eliasbitsch/PDE-Robotergreifer/videos/pde-projektplan/assets/work/ablauf_6_ablage.png

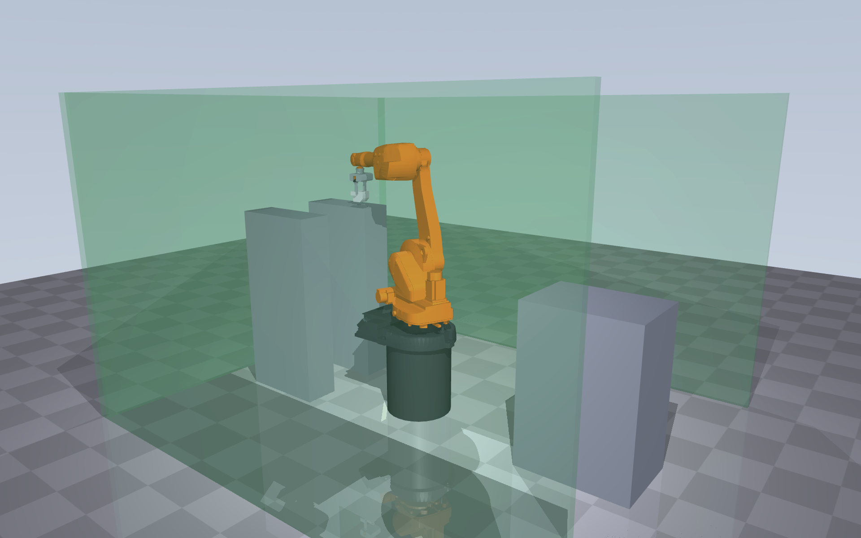
videos/pde-projektplan/assets/work/ablauf_6_ablage.png
