eliasbitsch/PDE-Robotergreifer/out/bilder/greifer_seite.png

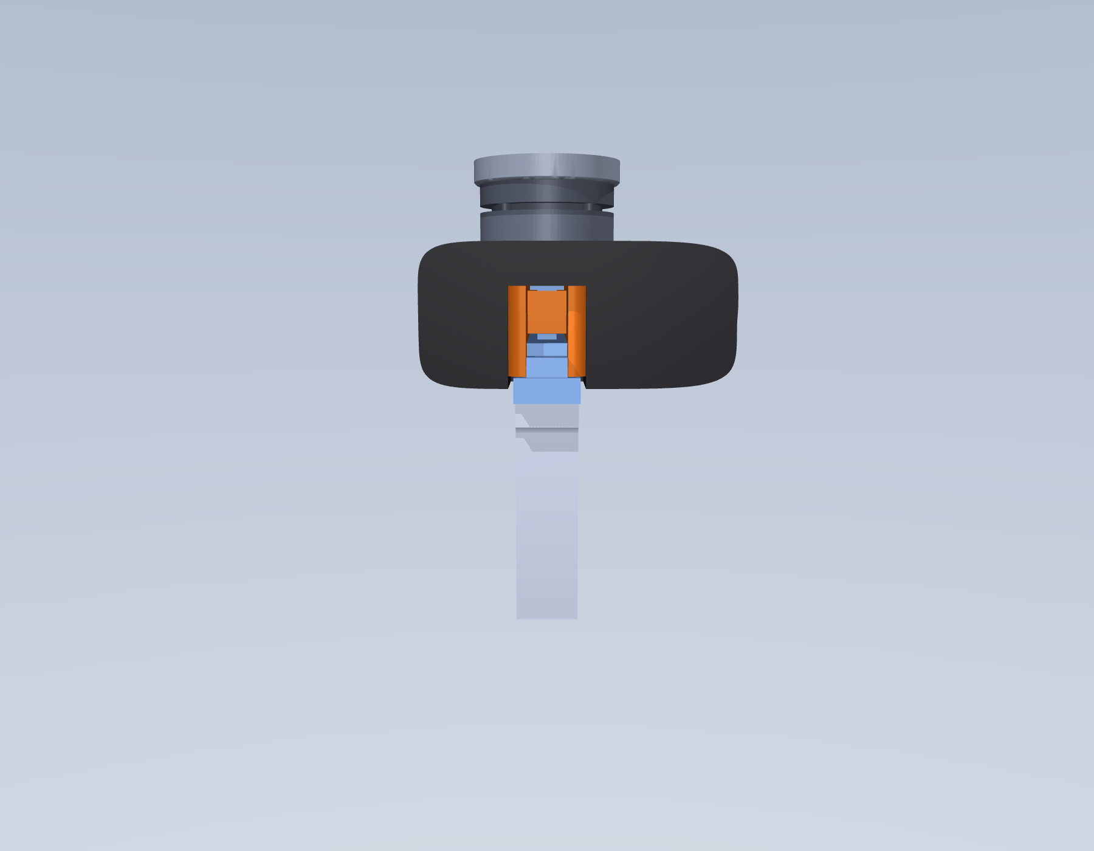
out/bilder/greifer_seite.png
