eliasbitsch/PDE-Robotergreifer/Elias/README.md

# Elias — System & Integration

Arbeitsbereich Bitsch Elias. Siehe [PLAN.md](../PLAN.md), Abschnitt 4.

| Ordner | Paket | Ergebnis |
|---|---|---|
| `01_Roboter` | E1 | Roboterauswahl, Aufstellungsstudie (Sockel 500 mm + Basisversatz 100 mm), Erreichbarkeitsnachweis |
| `02_CAD_Grundkoerper` | E2 | Gehaeuse, Antriebseinheit (Servo + Planetengetriebe + Haltebremse), Ritzel/Zahnstange, Fuehrung, Schnellwechsler, Roboterflansch |
| `03_Zeichnung` | E3 | Baugruppenzeichnung A3 + Stueckliste |
| `04_Simulation` | E4 | MuJoCo-Modell, Bahn Entnahme -> Ablage, Kollisionsprotokoll, Ablaufvideo |

Zusaetzlich E5: Infrastruktur (Repo, Onshape-Dokument, MCP-Anbindung, Parametertabelle) in `../gemeinsam/`.

**Schnittstelle zu Viktoriia:** die Anschraubebene Schlitten <-> Zange.
Ab KW 41 eingefroren, Aenderungen nur gemeinsam.
