eliasbitsch/PDE-Robotergreifer/gemeinsam/README.md

# Gemeinsam

| Ordner | Inhalt |
|---|---|
| `abgabe` | finale Abgabestruktur nach Abb. 2 der Angabe (4 Ordner), wird am Ende befuellt |
| `referenzen` | Datenblaetter, Normen, Literatur, Quellen fuer Reibwerte und Werkstoffkennwerte |

Hier liegen ausserdem die gemeinsame Parametertabelle und die Doku-Vorlage.

**Regel:** in `abgabe/` wird erst am Ende zusammengefuehrt, bewusst und gemeinsam.
Bis dahin arbeitet jede/r im eigenen Ordner.
