eliasbitsch/PDE-Robotergreifer/PLAN.md

# Projektplan — Robotergreifer, Bauteil B

**LV:** Produktdesign und Produktentwicklung, MRE WS 2026/27
**Gruppe:** 10 · **Bauteil:** B (PA 6, Ra 1,6)
**Team:** Bitsch Elias · Ovdiienko Viktoriia
**LV-Gruppen:** getrennt (BB-1 / BB-2) — Zwischenbericht und Endabgabe fahren wir **gemeinsam nach BB-1**
**Stand:** 14.09.2026 — Vorschlag, noch nicht abgestimmt

---

## 1. Worum es geht

Ein Roboter nimmt Bauteil B vom Pufferband (Höhe 1000 mm), fährt 1800 mm
horizontal und legt es auf einem Werkstückträger ab (Höhe 1300 mm).
Taktzeit 5 s je Bauteil. Wir konstruieren den Greifer dafür — das Bauteil
selbst ist gegeben und wird nicht verändert.

Abzugeben sind acht Punkte laut Angabe (Roboterauswahl, Greifkonzept,
Greifkraftberechnung, 3D-Konstruktion, analytische Festigkeit, FEM,
Baugruppenzeichnung, Ablaufsimulation mit Kollisionskontrolle), abgelegt in
der Ordnerstruktur aus Abb. 2 der Angabe.

---

## 2. Technische Festlegungen

Sechs Entscheidungen. Wenn Viktoriia eine davon anders sieht, ist **jetzt** der
richtige Zeitpunkt — nach dem Design Freeze in KW 40 kostet jede Änderung die
halbe Kette.

> **Geändert am 15.09.2026:** Die Mechanik war zuerst Zahnstange–Ritzel. Der
> Variantenvergleich in `cad/mechanismus.py` hatte mit Zahnstange, Keilhaken und
> Trapezspindel nur direkt übersetzende Schubmechanismen im Feld — die Familie
> der Gelenkgetriebe fehlte. Mit dem Viergelenk dazu kippt das Ergebnis, vor
> allem beim Kriterium „Halten bei Energieausfall": die selbsthemmende Spindel
> erspart die Haltebremse, die die Zahnstange zwingend gebraucht hätte.

| Thema | Festlegung | Warum |
|---|---|---|
| **Greifkonzept** | 2-Finger-Parallelgreifer, Backen | Bauteil B hat zwei ebene, parallele Seitenflächen im Abstand 70 mm. Formschluss ist nicht nötig, Reibschluss reicht. |
| **Antrieb** | **Servomotor** mit selbsthemmender Spindel bzw. Schnecke | Regelbare Greifkraft (PA 6 ist weich, Ra 1,6 darf nicht leiden), leise, keine Druckluft. **Selbsthemmend → keine Haltebremse nötig.** Das war bei der Zahnstange noch zwingend. |
| **Mechanik** | **Viergelenk (Parallelogramm) je Finger**, ein Motor treibt beide | Bauform nach Vorbild Robotiq 2F-85. Backen bleiben parallel, Spitze läuft auf einer Kreisbahn. Ohne die unteraktuierte Adaptivität des Originals — die ist im umgreifenden Modus statisch unbestimmt und bringt für zwei ebene Flächen nichts. |
| **CAD + FEM** | **Onshape** (parametrisch, browserbasiert) | Beide sehen dasselbe Modell live, keine Versionskonflikte, keine lokale Installation. FEM direkt am selben Modell, ohne Exportbruch. |
| **Berechnung / Doku** | **LaTeX** | Formeln, Einheiten und Querverweise bleiben konsistent; die Doku ist 10 Punkte wert und wächst ab M1 mit. |
| **Simulation** | **MuJoCo** | Siehe Abschnitt 3. |

### Kennwerte aus der Vorauslegung (zu bestätigen, nicht gesetzt)

- Bauteil B: 95 × 100 × 80 mm, 528,5 cm³, PA 6 (ρ = 1140 kg/m³) → **0,602 kg**
- Greifflächen: ±X, Backenabstand **70 mm**, 6200 mm² je Seite
- Bahnbeschleunigung aus Taktzeitbudget: **2,05 m/s²**
- Erforderliche Greifkraft: **14,3 N je Backe** (µ = 0,5 NBR/PA 6, S = 2,0)
- Startgeometrie Viergelenk (in V2 zu bestätigen): Lenkerlänge **90 mm**,
  Schwenkwinkel **±4,46°** um die Senkrechte zur Greifrichtung, Hub **14 mm je
  Seite** → **0,27 mm** Belagversatz über den Hub. Längere Lenker senken den
  Versatz weiter (120 mm → 0,20 mm), kürzere erhöhen ihn (40 mm → 0,62 mm).
- Referenz Robotiq 2F-85: elektrisch 24 V, **20–235 N**, 85 mm Hub, 5 kg
  Traglast, ~1,3 kg, Flansch ISO 9409-1-50-4-M6. Kraft ist in keiner Variante
  der Engpass — wir brauchen 14,3 N.
- Roboter: **ABB IRB 1600-6/1.45**
- Wichtigster Befund: Mit dem Roboter mittig auf dem Boden ist der Ablauf
  **nicht ausführbar** — nicht wegen der Reichweite, sondern wegen Achse 5
  (±115°). Lösung: **Sockel 500 mm + Basisversatz 100 mm**. Das gehört als
  Erkenntnis in den Bericht, nicht versteckt.

---

## 3. Simulation: MuJoCo statt Gazebo

**Entscheidung: MuJoCo.**

Gazebo wäre die richtige Wahl, wenn wir gegen einen echten ABB-Controller mit
ROS 2 und MoveIt fahren würden — Sensorsimulation, Plugins, ganze Anlagenwelt.
Das brauchen wir nicht. Die Angabe verlangt "visuelle Darstellung inkl.
Kollisionskontrolle des Arbeitsablaufes", also Kinematik, Kollision und ein
Video.

Dafür ist MuJoCo besser:

- **Läuft ohne ROS**, direkt aus Python — kein Stack, der eine Woche Setup frisst
- **Kontaktkräfte** sind auswertbar. Wir können zeigen, dass das Bauteil unter
  der berechneten Greifkraft *tatsächlich* nicht rutscht, statt es nur zu
  behaupten. Das ist ein echtes Argument im Bericht.
- **Headless-Rendering** in guter Qualität → Bilder für die Doku und das Video
  entstehen im selben Lauf
- **Läuft bereits.** `sim/aufstellung.py` und `sim/ablauf.py` funktionieren,
  inklusive Levenberg-Marquardt-IK mit Konfigurationstreue. Das Rad ist schon
  rund.

Gazebo hätte gegenüber MuJoCo hier nur Nachteile: schwerer, ROS-abhängig, auf
Windows nur über WSL, und kein Mehrwert für das, was abgegeben wird.

---

## 3a. Wofür es Punkte gibt

100 Punkte insgesamt. Die Verteilung steht in der Einführungsfolie und sie ist
der wichtigste Planungsinput überhaupt:

| Arbeitspaket | Punkte | Wer |
|---|---:|---|
| **3D-Konstruktion des Greifers** | **20** | Elias + Viktoriia |
| Allgemein (Ausführung der technischen Dokumentation) | 10 | beide |
| Auswahl eines geeigneten Roboters inkl. Begründung | 10 | Elias |
| Konzeptskizze des Greifers | 10 | Viktoriia |
| Berechnung und mechanische Auslegung des Greifmechanismus | 10 | Viktoriia |
| Analytische Berechnung der Greiferzange | 10 | Viktoriia |
| Numerische Berechnung der Greiferzange (FEM) | 10 | Elias |
| Baugruppenzeichnung inklusive Stückliste | 10 | Elias |
| Kollisionskontrolle und visuelle Darstellung des Arbeitsablaufes | 10 | Elias |

**Notenskala:** ≥88 % Sehr Gut · ≥75 % Gut · ≥63 % Befriedigend · ≥50 % Genügend · <50 % Nicht genügend

Zwei Schlüsse daraus:

- **Die 3D-Konstruktion ist doppelt gewichtet.** Sie bekommt die meiste Zeit
  und wird von beiden getragen — nicht nebenbei erledigt.
- **Die Dokumentation allein bringt 10 Punkte**, unabhängig vom Inhalt. Das
  ist die billigste Note im ganzen Projekt und wird deshalb nicht ans Ende
  geschoben (siehe unten).

### Die fünf Warnungen der LV-Leitung

Aus der Einführungsfolie, wörtlich — der Plan ist genau darauf gebaut:

| Warnung | Wie der Plan sie abfängt |
|---|---|
| 1. Konstruktion nicht ohne Berechnung beginnen | Greifkraft (V2) liegt in M1, **vor** dem CAD-Start in M2. Design Freeze trennt beides sauber. |
| 2. FEM nicht zu spät starten | Die FEM (E5) liegt in M3 und ist **vor** dem Zwischenbericht fertig, nicht danach. |
| 3. Zeichnungen: Aufwand nicht unterschätzen | Zeichnung + Stückliste (E3) startet im Dezember, nicht im Januar. Zwei volle Wochen. |
| 4. Dokumentation nicht erst in der letzten Woche | Läuft ab M1 mit. Jedes Paket wird geschrieben, **wenn** es fertig ist. Januar ist nur noch Zusammenführen. |
| 5. Zwischenbericht ernst nehmen | Eigener Meilenstein mit Inhaltsliste, 4 Tage Puffer davor. |

---

## 4. Aufgabenteilung

Zwei Hälften, die jede für sich eine geschlossene Geschichte erzählen.
Niemand bekommt Restarbeiten.

### Elias — System & Integration

| # | Paket | Ergebnis | Ordner |
|---|---|---|---|
| E1 | **Roboterauswahl & Aufstellung** | Auswahlrechnung (Reichweite, Taktzeit, Traglast), Aufstellungsstudie Sockel/Basisversatz, Nachweis der Erreichbarkeit aller Stützpunkte | `Elias/01_Roboter` |
| E2 | **Greifer-Grundkörper** | Gehäuse, Antriebseinheit (Servo + selbsthemmende Spindel), Viergelenk mit Lagerstellen, Schnellwechsler, Roboterflansch ISO 9409-1-50-4-M6 | `Elias/02_CAD_Grundkoerper` |
| E3 | **Baugruppenzeichnung & Stückliste** | A3-Zeichnung, Positionsnummern, Stückliste mit Kauf-/Fertigungsteilen | `Elias/03_Zeichnung` |
| E4 | **Ablaufsimulation & Kollisionskontrolle** | MuJoCo-Modell, Bahn Entnahme → Ablage, Kollisionsprotokoll, Ablaufvideo | `Elias/04_Simulation` |
| E5 | **FEM der Greiferzange** | Netz, Randbedingungen, Netzkonvergenz, Spannung und Verformung; Abgleich gegen Viktoriias analytische Rechnung | `Elias/05_FEM` |
| E6 | **Infrastruktur** | Repo, Onshape-Dokument, MCP-Anbindung, Parametertabelle, Doku-Vorlage | `gemeinsam/` |

### Viktoriia — Auslegung & Nachweis

| # | Paket | Ergebnis | Ordner |
|---|---|---|---|
| V1 | **Greifkonzept & Konzeptskizze** | Variantenvergleich nach VDI 2225 — **mit dem Robotiq 2F-85 als marktüblicher Referenz im Feld**, dazu Viergelenk, Zahnstange, Keilhaken, Spindel. Begründung der Wahl, bemaßte Konzeptskizze | `Viktoriia/01_Konzept` |
| V2 | **Greifkraft & Antriebsauslegung** | Kraftbilanz (Gewicht + Beschleunigung + Sicherheit), Reibwert mit Quelle, Flächenpressung auf PA 6, **Viergelenk über virtuelle Arbeit mit Nachweis des Übertragungswinkels im ungünstigsten Punkt**, Spindelauslegung inkl. Selbsthemmung, Motorauswahl mit Reserve | `Viktoriia/02_Auslegung` |
| V3 | **Greiferzange & Weichbacken (CAD)** | Parametrische Zange in Onshape, Backentasche, Kontur passend zu Bauteil B | `Viktoriia/03_CAD_Zange` |
| V4 | **Analytischer Festigkeitsnachweis** | Biegespannung und Durchbiegung der Zange von Hand gerechnet, Annahmen und Quellen sauber belegt — die Referenz, gegen die die FEM antritt | `Viktoriia/04_Nachweis` |
| V5 | **FDM-Validierung** | Zange drucken, Durchbiegung unter definierter Last messen, gegen Elias' FEM halten | `Viktoriia/05_FDM` |

**Warum dieser Schnitt:** Viktoriia konstruiert die Zange und rechnet sie
analytisch durch. Elias rechnet dieselbe Zange numerisch nach. Damit prüfen
zwei Personen unabhängig dasselbe Bauteil auf zwei Wegen — genau das verlangt
die Angabe, und eine Abweichung fällt sofort auf, statt sich in einer Hand zu
verstecken.

Der gedruckte Nachweis (V5) liegt aus demselben Grund bei Viktoriia: wer die
FEM gerechnet hat, soll sie nicht selbst bestätigen. Die Schnittstelle zwischen beiden ist eine
einzige Fläche: die **Anschraubebene Schlitten ↔ Zange**. Die wird in KW 41
festgelegt und danach nicht mehr angefasst.

### Gemeinsam

- **Dokumentation** — jede/r schreibt die eigenen Kapitel, gegenseitiges Review
- **Cross-Review** vor jedem Meilenstein: Elias prüft Viktoriias Rechnungen
  nach, Viktoriia prüft Elias' Modell auf Fertigbarkeit
- **Abgabe-ZIP** in der Struktur aus Abb. 2

---

## 5. Die FDM-Idee

Das verlangt niemand — aber es ist billig und hebt die Arbeit deutlich.

Wir drucken die Greiferzange aus PLA/PETG im Maßstab 1:1, klemmen sie ein,
hängen eine definierte Last ans freie Ende und **messen die Durchbiegung**.
Dann rechnen wir dieselbe Geometrie mit dem E-Modul des Druckwerkstoffs neu
und vergleichen drei Zahlen: analytisch, FEM, gemessen.

Was das bringt:

- Der Vergleich analytisch/numerisch wird vom Pflichtpunkt zum belastbaren
  Ergebnis — mit einem realen dritten Datenpunkt
- Man sieht sofort, ob die Einspannung im FEM-Modell zu steif angenommen war.
  Das ist der klassische Fehler und wir können ihn belegen statt vermuten.
- Die gedruckte Zange lässt sich im Video zeigen. Eine echte Backe in der Hand
  schlägt jedes Rendering.

**Wichtig für die Ehrlichkeit im Bericht:** Gedruckt wird PLA, gebaut wird
EN AW-7075. Der Test validiert das *Modell* (Randbedingungen, Lasteinleitung,
Netz), nicht das Bauteil. Genau so schreiben wir es hin.

---

## 6. Timeline

### Die zwei harten Termine

Wir sind in getrennten LV-Gruppen, liefern aber gemeinsam ab. Wir fahren beide
nach **BB-1** — das sind die **früheren** Termine:

| | Termin | Was |
|---|---|---|
| 🔴 **Zwischenbericht** | **Do 26.11.2026, 17:50, Präsenz** | BB-1 statt BB-2 (03.12.) — eine Woche früher |
| 🔴 **Endkontrolle** | **Fr 15.01.2027, 16:10, Präsenz** | BB-1 statt BB-2 (22.01.) — eine Woche früher |

**Das kostet uns je eine Woche Puffer.** Bewusste Entscheidung, aber sie muss
mit der LV-Leitung (Saliger) abgesprochen sein — wer in BB-2 ist, präsentiert
beim Zwischenbericht in einer fremden Gruppe. Das ist Punkt 0 auf der
Klärliste.

### LV-Termine als Taktgeber (BB-1)

Die Vorlesungen geben den Rhythmus vor — wir legen die Pakete dahinter, nicht
davor:

| Datum | Thema | Was das für uns heißt |
|---|---|---|
| Do 17.09. | Einführung OnShape | CAD-Start **danach**, nicht davor |
| Sa 19.09. | Modellierung und Zeichnung | Modellier-Handwerkszeug sitzt |
| Di 22.09. | StüLi, Blech, MDB | Stücklisten-Logik für E3 |
| Sa 24.10. | Baugruppen, Datenaustausch | fällt genau in die CAD-Phase — Timing passt |
| Mi 04.11. | Digitale Absicherung, Simulation | direkt vor der Simulationsphase |
| **Do 26.11.** | **Zwischenbericht** | 🔴 |
| Mi 02.12. | CAE–CAD–CAP–CAM Prozesskette | — |
| **Fr 15.01.** | **Endkontrolle, Fragestunde** | 🔴 |

### Meilensteine

| Meilenstein | Deadline | Ergebnis | Wer |
|---|---|---|---|
| **M0 — Kickoff** | So 20.09. | Plan abgestimmt, Rollen fix, Onshape + Repo stehen, Klärliste raus | beide |
| **M1 — Konzept steht** | So 04.10. | Roboter gewählt (E1), Greifkonzept + Skizze (V1), Greifkraft gerechnet (V2) → **Design Freeze** | beide |
| **M2 — CAD schließt** | So 01.11. | Zange (V3) und Grundkörper (E2) getrennt konstruiert, Baugruppe schließt kollisionsfrei, Schnittstelle eingefroren | beide |
| **M3 — Nachweise** | So 22.11. | Analytisch fertig (V4), FEM gerechnet inkl. Netzkonvergenz (E5), beide Wege verglichen | beide |
| 🔴 **Zwischenbericht** | **Do 26.11.** | Präsentation: Konzept, Auslegung, CAD, erste Nachweise | beide |
| **M4 — Zeichnung + Simulation + FDM** | So 20.12. | Baugruppenzeichnung + Stückliste (E3), MuJoCo-Ablauf + Kollisionsprotokoll + Video (E4), Zange gedruckt und vermessen (V5) | parallel |
| *Weihnachtspause* | 21.12.–03.01. | — | — |
| **M5 — Zusammenführen** | So 11.01. | Doku zusammengeführt, Cross-Review, ZIP gepackt | beide |
| 🔴 **Endkontrolle** | **Fr 15.01.** | ZIP hochgeladen, Präsenztermin | beide |

**Puffer:** vor dem Zwischenbericht 4 Tage, vor der Endkontrolle 4 Tage. Das
ist knapp. Deshalb liegt die FEM-Kette **vor** dem Zwischenbericht und nicht
danach — wenn dort etwas schiefgeht, haben wir im Dezember noch Luft.

**Die Zeichnung liegt bewusst im Dezember, nicht im Januar.** Warnung 3 der
LV-Leitung. Zwei Wochen für Zeichnung und Stückliste sind nicht großzügig,
sondern realistisch.

**Dokumentation läuft ab M1 mit.** Jedes Paket wird geschrieben, wenn es
fertig ist, nicht am Ende. M5 ist Zusammenführen und Korrekturlesen — kein
Schreiben. Das ist Warnung 4, und sie ist 10 Punkte wert.

**Fixer Termin:** jede Woche ein kurzer Sync, 20 Minuten, Stand + Blocker.

---

## 7. Offene Punkte

Diese müssen früh geklärt werden, weil sie nach hinten teuer werden:

0. **Getrennte LV-Gruppen.** Wir sind in BB-1 und BB-2, wollen aber gemeinsam
   nach BB-1 fahren (Zwischenbericht 26.11., Endkontrolle 15.01.).
   Entspannend: laut Einführungsfolie muss **bei Zwischenbericht und
   Endkontrolle mindestens eine Person pro Gruppe anwesend sein** — nicht
   beide. Trotzdem mit Alexandra Saliger abklären, ob die Anwesenheit in der
   jeweils anderen Kohorte angerechnet wird. Zusätzlich gilt **75 %
   Anwesenheitspflicht**, die zählt jede/r in der eigenen Gruppe.
   **Vor allem anderen klären.**
1. **Gruppennummer.** `task.md` sagt Gruppe 10, Tab. 1 der Angabe kennt nur
   Gruppen 1–8 (Bauteil B = Gruppe 2). Bei der LV-Leitung nachfragen, bevor
   irgendein Dokument mit einer Nummer im Kopf gedruckt wird.
2. **Ablageorientierung am Werkstückträger.** Laut Angabe wird das bei der
   Angabenausgabe definiert. Aktuell mit 90° Drehung gerechnet. Wenn die
   Orientierung anders ist, ändert sich die Bahn und möglicherweise die
   Greifrichtung.
3. **FDM-Drucker.** Verfügbarkeit und Werkstoff klären (Labor oder privat).
3a. **Übertragungswinkel.** Beim Viergelenk ist die Backenkraft **nicht**
   konstant über den Hub. Der ungünstigste Punkt muss nachgewiesen werden —
   das ist der Preis für die Bauform und gehört in V2, nicht ans Ende.
3b. **Belagversatz auf der Greiffläche.** 0,27 mm Schrubben bei 90 mm Lenkern.
   Für Ra 1,6 auf PA 6 nachweisen, dass der Weichbelag das elastisch aufnimmt.
3c. **Onshape-FEM.** Prüfen, ob der Education-Plan die Simulation freischaltet.
   Falls nicht, springt die bestehende CalculiX-Kette ein — Ergebnis
   gleichwertig, nur mehr Handarbeit.
4. **Onshape-Lizenz.** Free-Plan macht Dokumente öffentlich. Für eine
   Studienarbeit ist das meist egal, sollte aber bewusst entschieden sein —
   Education-Plan ist kostenlos und privat.

---

## 8. Arbeitsweise im Repo

```
PDE/
├─ Elias/          ← Elias arbeitet nur hier
├─ Viktoriia/      ← Viktoriia arbeitet nur hier
├─ gemeinsam/      ← Parameter, Vorlagen, Abgabe-ZIP
│  ├─ abgabe/      ← finale Struktur nach Abb. 2
│  └─ referenzen/
├─ cad/ fem/ sim/  ← bestehende Skriptkette (Vorarbeit, bleibt als Referenz)
└─ PLAN.md
```

**Regel:** jede/r committet nur im eigenen Ordner. Dann gibt es keine
Merge-Konflikte. Zusammengeführt wird ausschließlich in `gemeinsam/abgabe/`,
und zwar am Ende, bewusst und gemeinsam.

Commit-Nachrichten auf Deutsch, eine Zeile, was sich geändert hat und warum.

---

## 9. Was Viktoriia dazu sagen soll

Der Plan ist ein **Vorschlag**, kein Beschluss. Konkret bitte Rückmeldung zu:

- Passt die Aufteilung? Wenn du lieber CAD statt FEM machst (oder umgekehrt),
  tauschen wir — die Pakete sind so geschnitten, dass V3↔E2 und V4↔E4 tauschbar
  sind.
- Onshape okay, oder arbeitest du lieber in etwas anderem? (SolidWorks,
  Fusion, Inventor — dann müssen wir nur die Schnittstelle über STEP klären.)
- Ist dir die Timeline zu eng oder zu locker?
- Die FEM ist bewusst zu Elias gewandert, damit deine Seite nicht überläuft.
  Du rechnest analytisch, er numerisch — zwei unabhängige Wege auf dasselbe
  Bauteil. Wenn du die FEM lieber selbst machst, tauschen wir zurück.
