eliasbitsch/PDE-Robotergreifer/Viktoriia/README.md

# Viktoriia — Auslegung & Nachweis

Arbeitsbereich Ovdiienko Viktoriia. Siehe [PLAN.md](../PLAN.md), Abschnitt 4.

| Ordner | Paket | Ergebnis |
|---|---|---|
| `01_Konzept` | V1 | Variantenvergleich Greifkonzept (VDI 2225), Begruendung, bemasste Konzeptskizze |
| `02_Auslegung` | V2 | Greifkraft (Gewicht + Beschleunigung + Sicherheit), Reibwert mit Quelle, Flaechenpressung auf PA 6, Ritzelmoment, Motorauswahl, Bremse |
| `03_CAD_Zange` | V3 | Greiferzange + Weichbacken, parametrisch in Onshape |
| `04_Nachweis` | V4 | Biegespannung und Durchbiegung analytisch, FEM mit Netzkonvergenz, Vergleich beider Wege |
| `05_FDM` | V5 | Zange gedruckt, Greifversuch, Durchbiegung gemessen, gegen FEM gehalten |

**Der rote Faden:** du konstruierst genau das Bauteil, das du danach berechnest,
pruefst und druckst. V3 -> V4 -> V5 ist eine Kette.

**Schnittstelle zu Elias:** die Anschraubebene Schlitten <-> Zange.
Ab KW 41 eingefroren, Aenderungen nur gemeinsam.

**Wenn dir etwas nicht passt:** Abschnitt 9 in PLAN.md. Die Pakete V3<->E2 und
V4<->E4 sind bewusst tauschbar geschnitten.
