eliasbitsch/PDE-Robotergreifer/angabe_bilder/s2_Image30.png

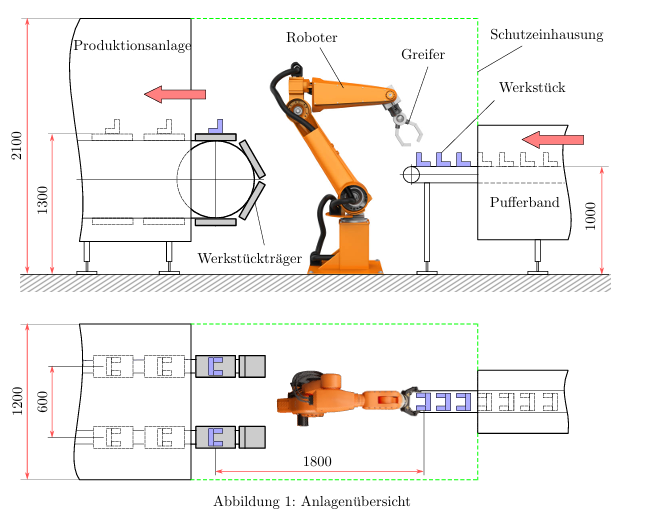
angabe_bilder/s2_Image30.png
