eliasbitsch/PDE-Robotergreifer/angabe_bilder/s3_Image33.jpg

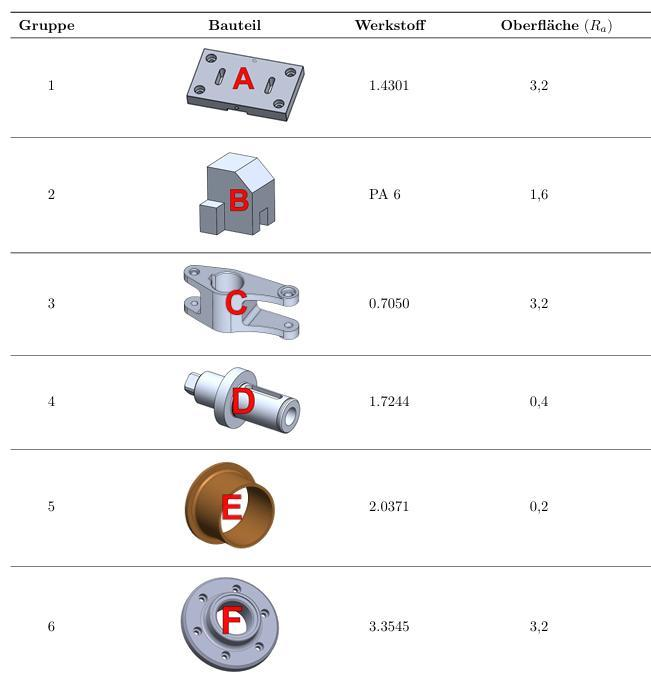
angabe_bilder/s3_Image33.jpg
