eliasbitsch/PDE-Robotergreifer/angabe_bilder/s3_Image34.jpg

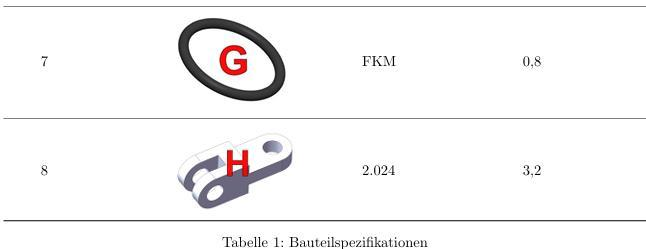
angabe_bilder/s3_Image34.jpg
