eliasbitsch/PDE-Robotergreifer/angabe_bilder/s5_Image47.png

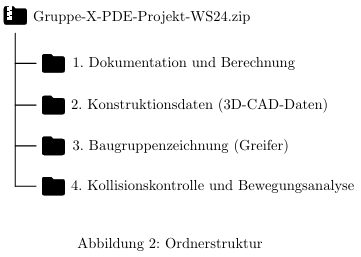
angabe_bilder/s5_Image47.png
