eliasbitsch/PDE-Robotergreifer/out/bilder/greifer_front.png

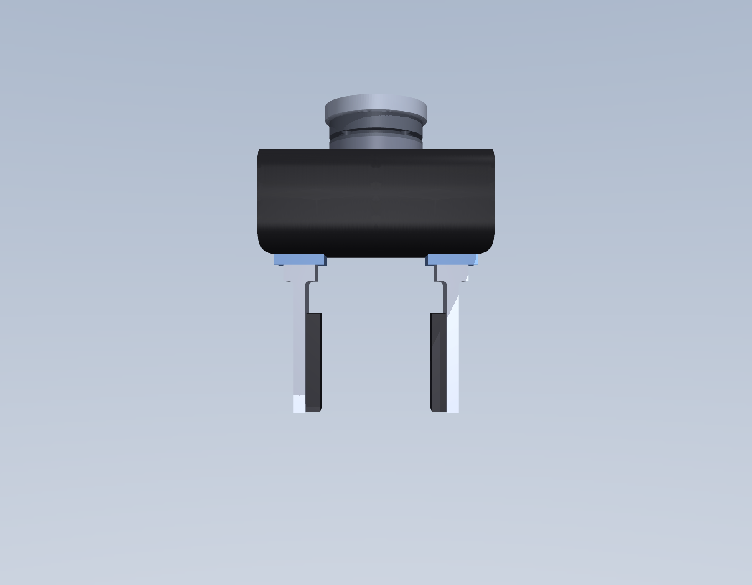
out/bilder/greifer_front.png
