eliasbitsch/PDE-Robotergreifer/out/bilder/greifer_mechanik.png

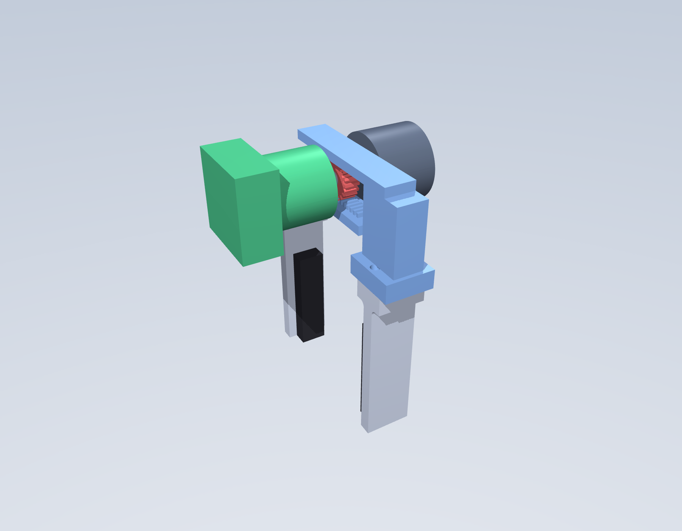
out/bilder/greifer_mechanik.png
