eliasbitsch/PDE-Robotergreifer/out/bilder/greifer_mechanik_oben.png

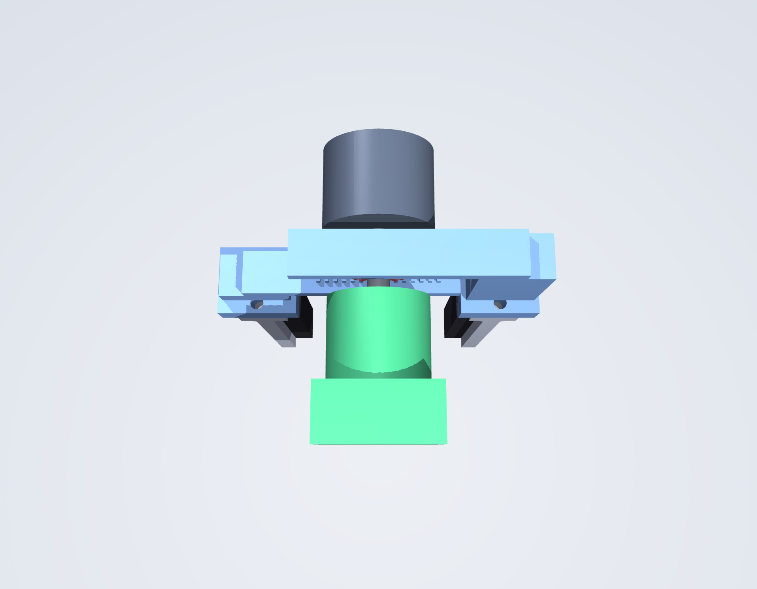
out/bilder/greifer_mechanik_oben.png
