eliasbitsch/PDE-Robotergreifer/out/bilder/onshape_design_zu.png

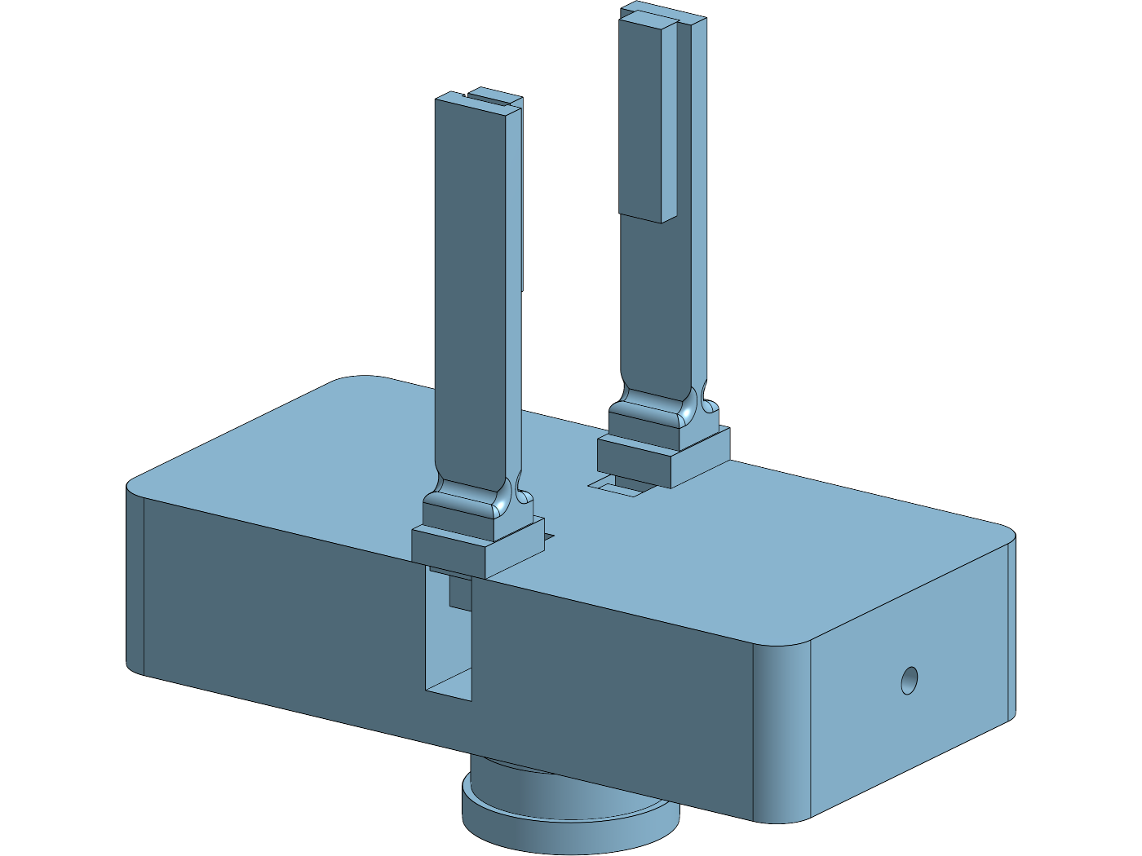
out/bilder/onshape_design_zu.png
