eliasbitsch/PDE-Robotergreifer/out/bilder/onshape_schnitt.png

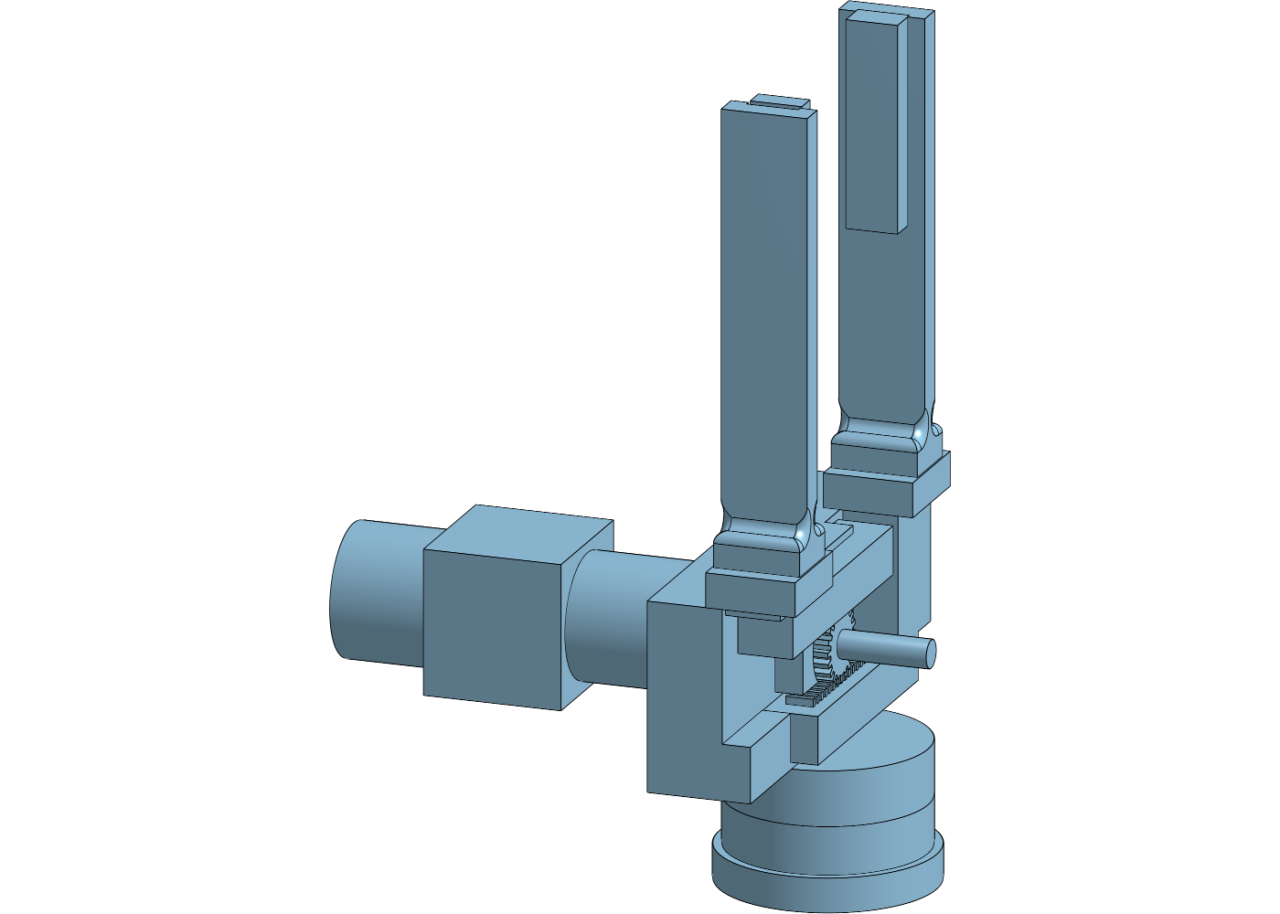
out/bilder/onshape_schnitt.png
