eliasbitsch/PDE-Robotergreifer/out/bilder/onshape_zange.png

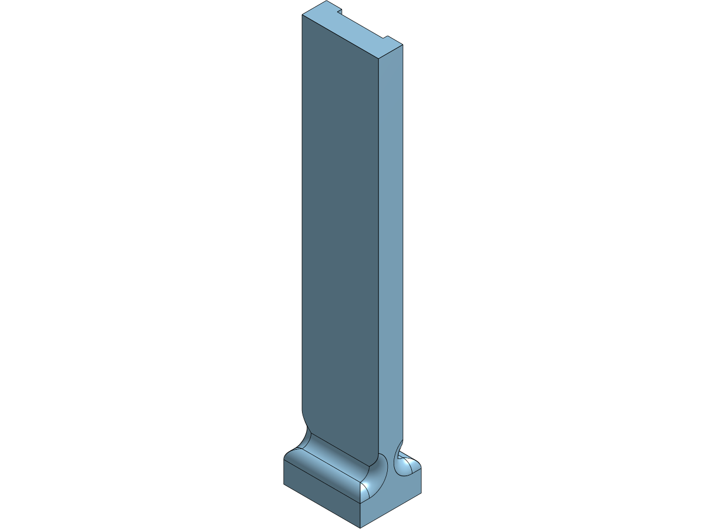
out/bilder/onshape_zange.png
