eliasbitsch/PDE-Robotergreifer/sim/mj_front.png

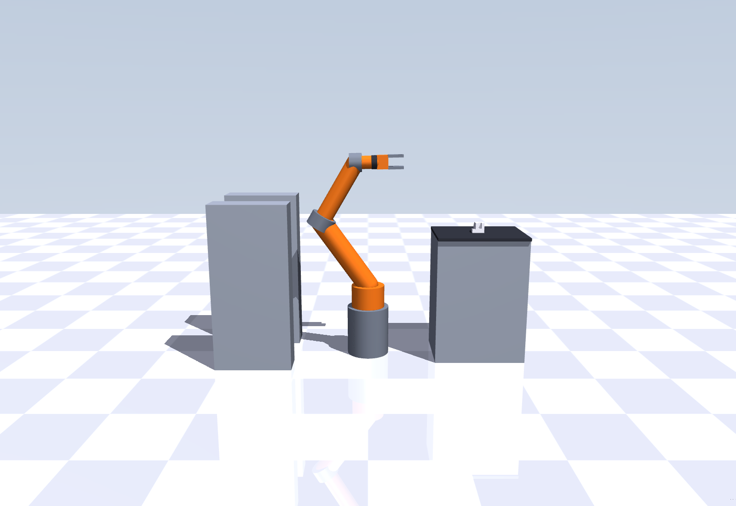
sim/mj_front.png
