eliasbitsch/PDE-Robotergreifer/sim/mj_iso.png

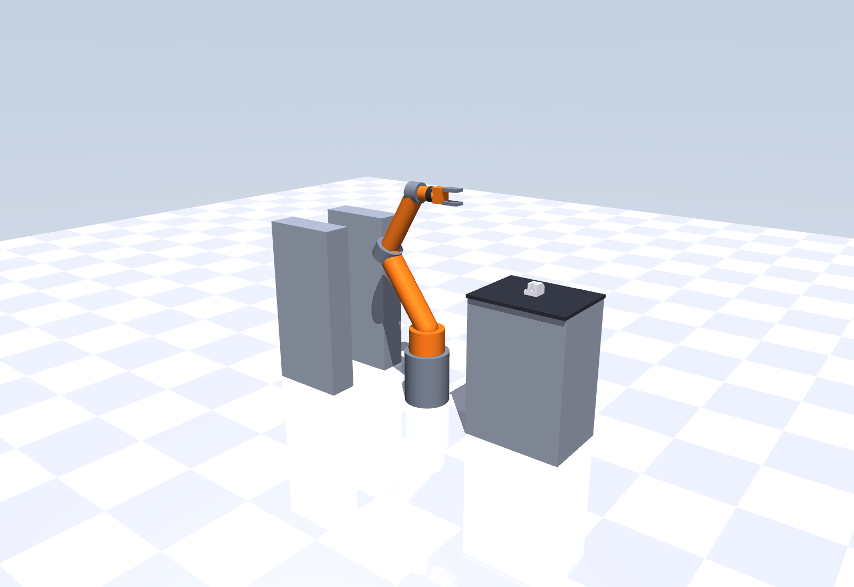
sim/mj_iso.png
