eliasbitsch/PDE-Robotergreifer/sim/szene.png

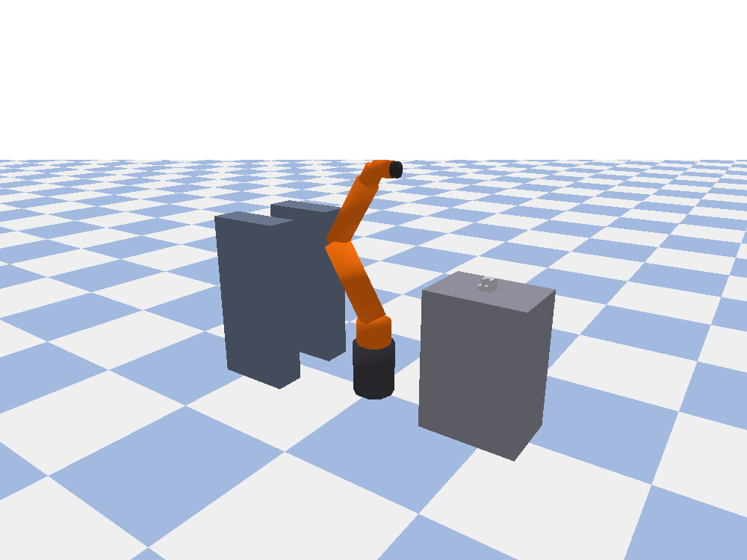
sim/szene.png
