eliasbitsch/PDE-Robotergreifer/videos/pde-projektplan/assets/part/linkage.png

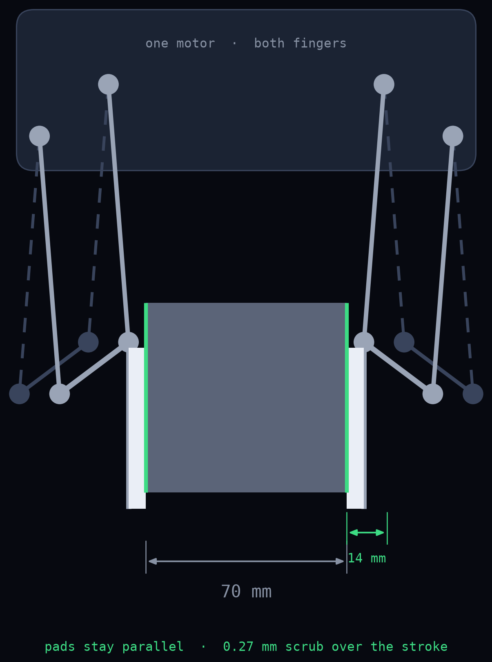
videos/pde-projektplan/assets/part/linkage.png
