eliasbitsch/PDE-Robotergreifer/videos/pde-projektplan/assets/part/part_b.png

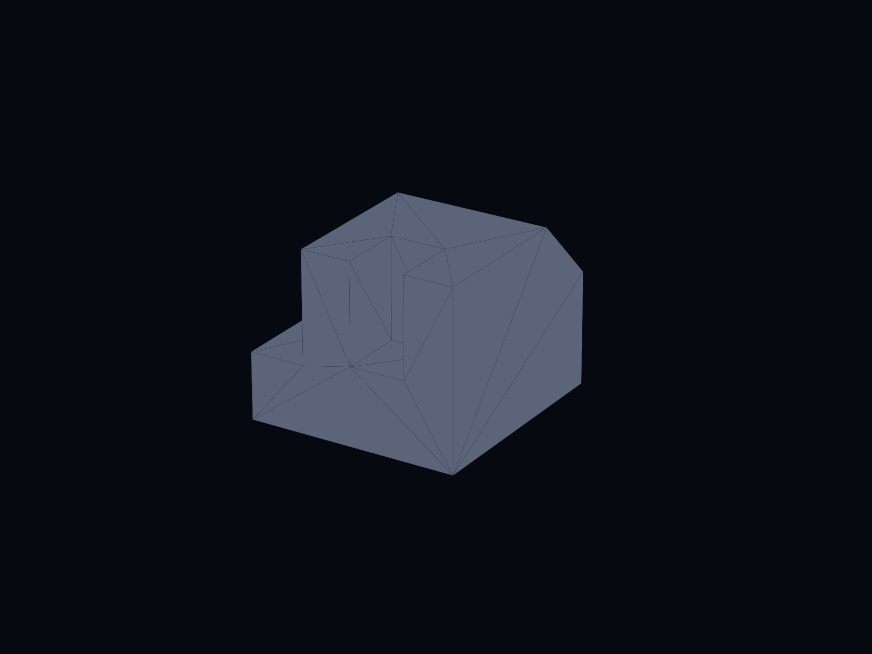
videos/pde-projektplan/assets/part/part_b.png
