eliasbitsch/PDE-Robotergreifer/videos/pde-projektplan/assets/part/part_b_grip.png

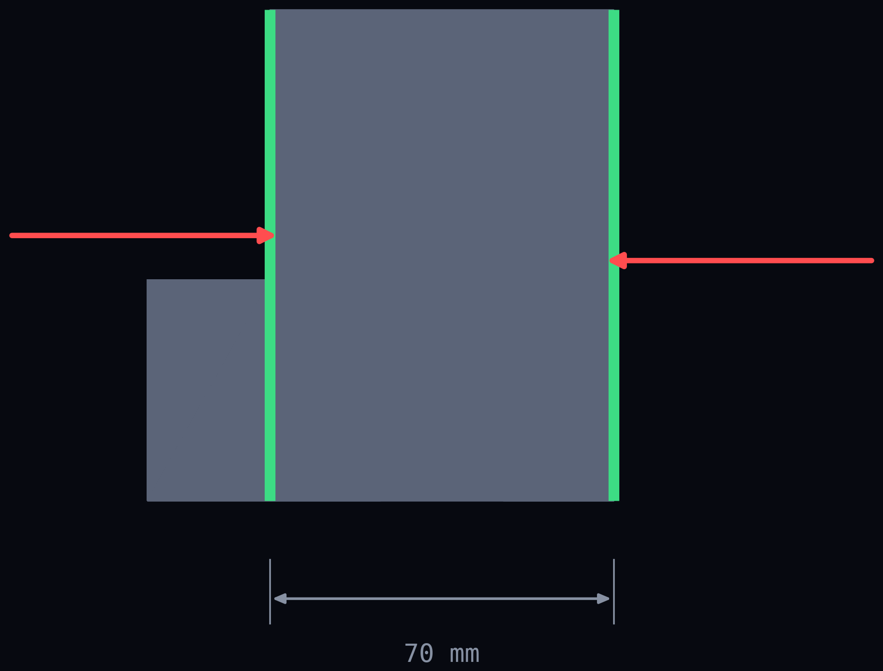
videos/pde-projektplan/assets/part/part_b_grip.png
