eliasbitsch/PDE-Robotergreifer/videos/pde-projektplan/assets/part/part_b_title.png

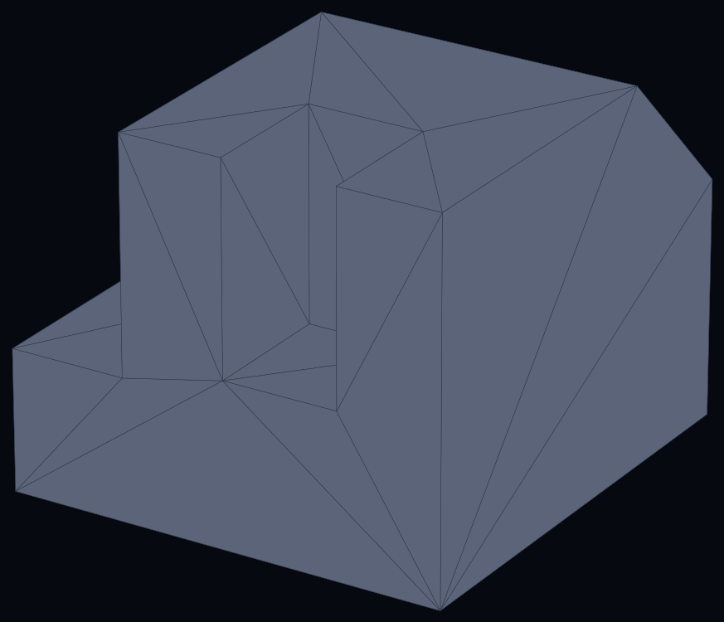
videos/pde-projektplan/assets/part/part_b_title.png
