eliasbitsch/PDE-Robotergreifer/videos/pde-projektplan/assets/shots/github.png

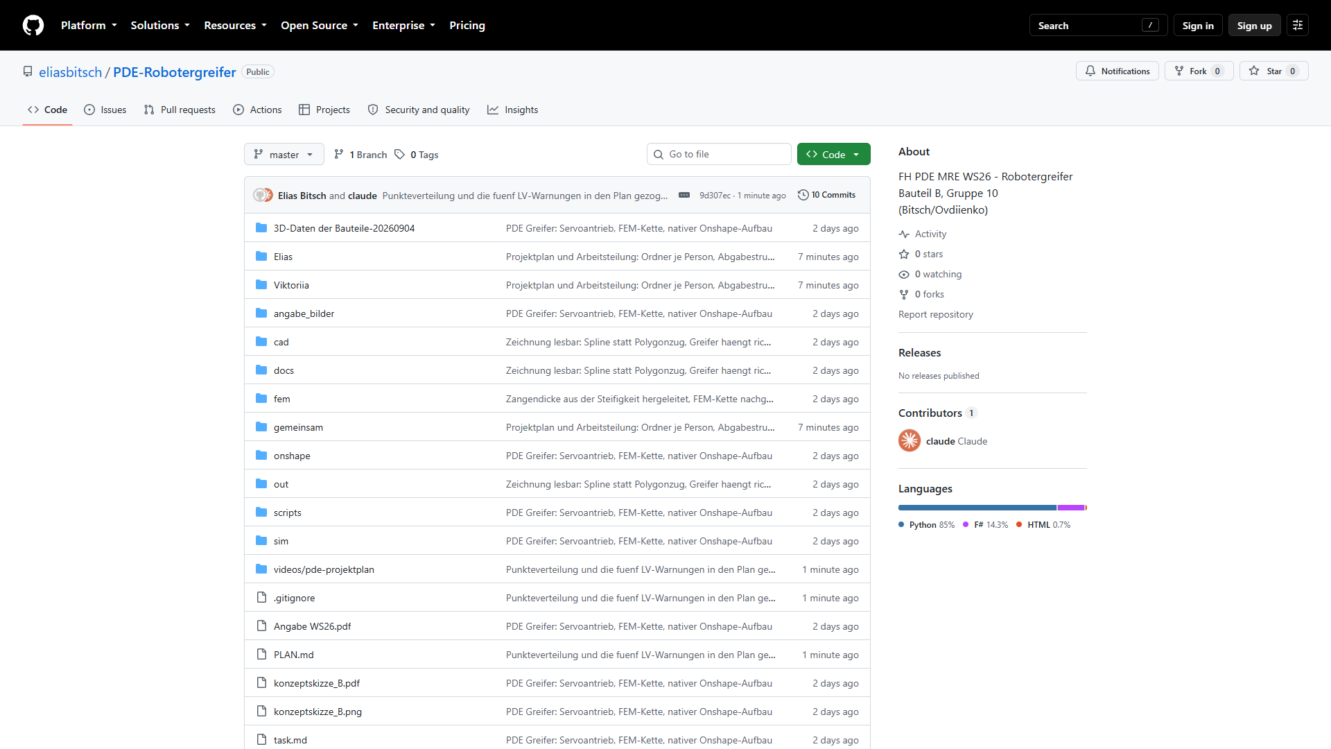
videos/pde-projektplan/assets/shots/github.png
