eliasbitsch/PDE-Robotergreifer/videos/pde-projektplan/assets/shots/mcp.png

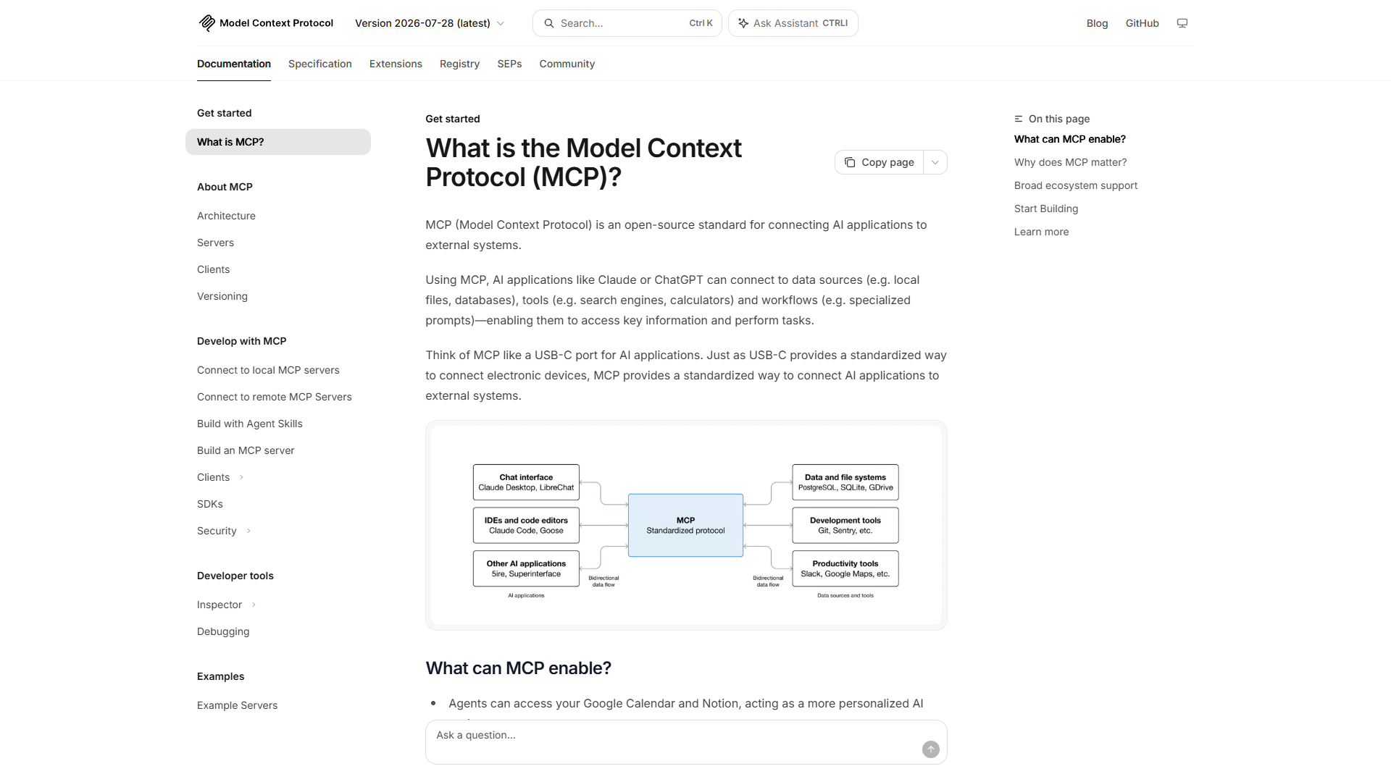
videos/pde-projektplan/assets/shots/mcp.png
