eliasbitsch/PDE-Robotergreifer/videos/pde-projektplan/assets/shots/mujoco.png

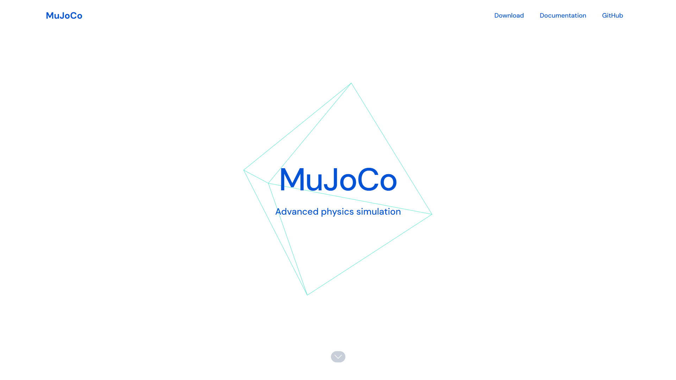
videos/pde-projektplan/assets/shots/mujoco.png
