eliasbitsch/PDE-Robotergreifer/videos/pde-projektplan/assets/shots/onshape.png

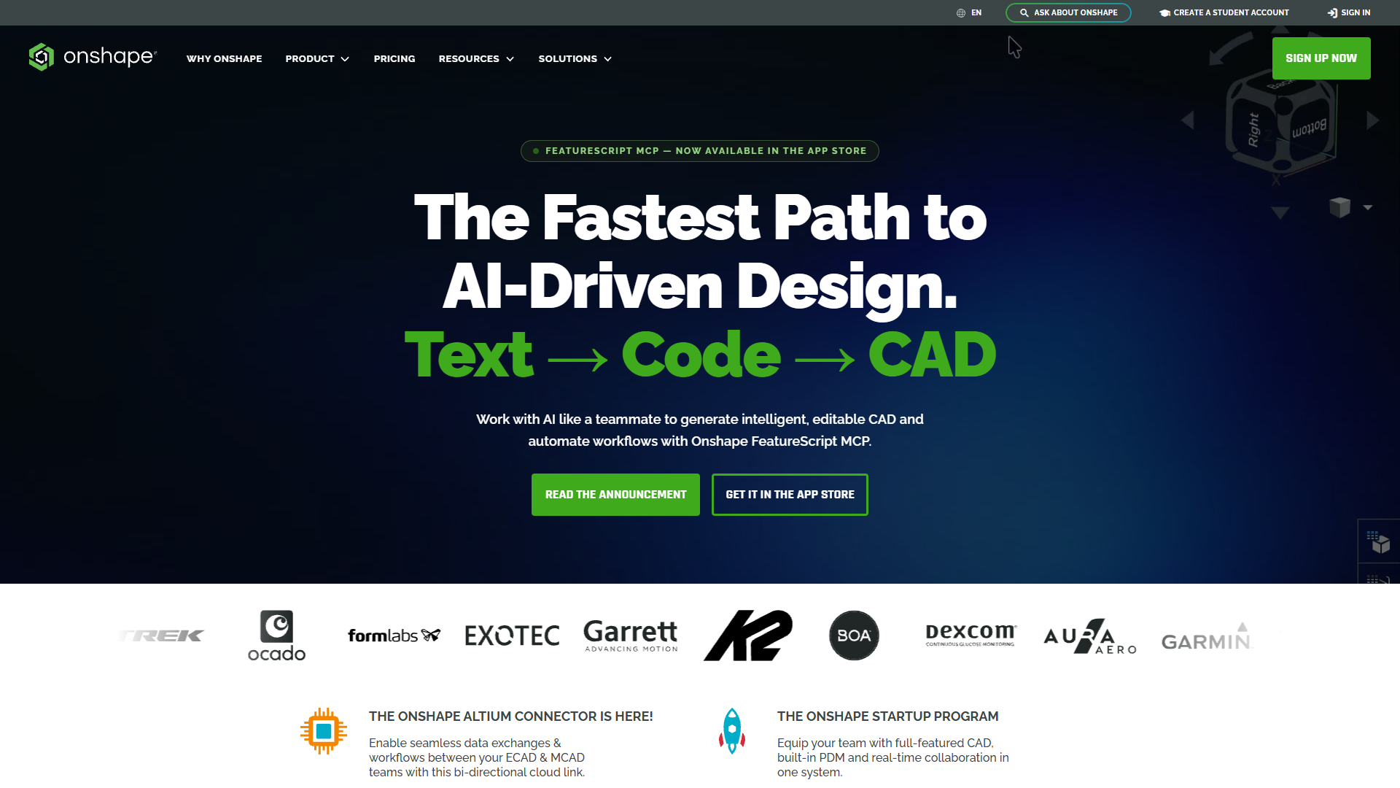
videos/pde-projektplan/assets/shots/onshape.png
