eliasbitsch/PDE-Robotergreifer/videos/pde-projektplan/assets/work/aufstellung.png

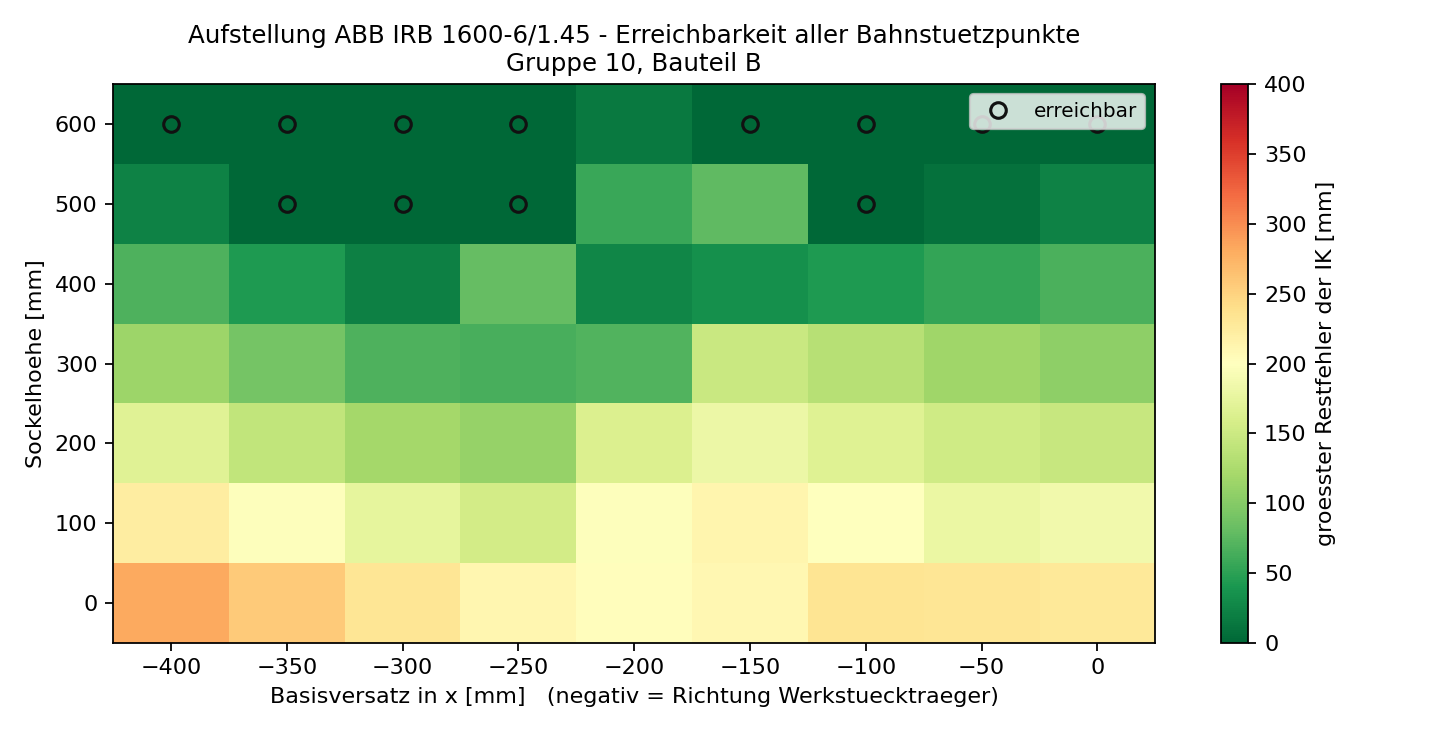
videos/pde-projektplan/assets/work/aufstellung.png
