eliasbitsch/PDE-Robotergreifer/videos/pde-projektplan/assets/work/fem_konvergenz.png

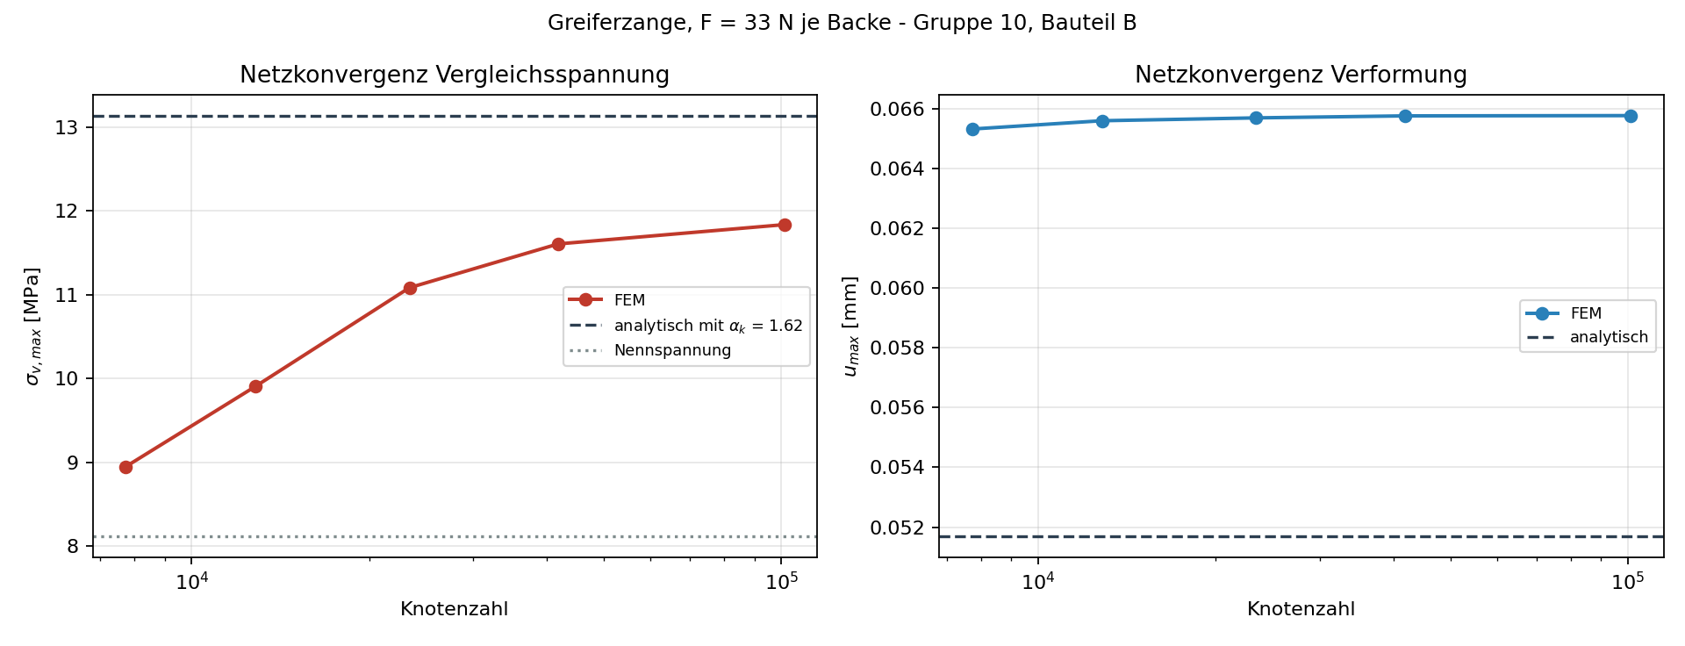
videos/pde-projektplan/assets/work/fem_konvergenz.png
