eliasbitsch/PDE-Robotergreifer/videos/pde-projektplan/assets/work/greifer_iso.png

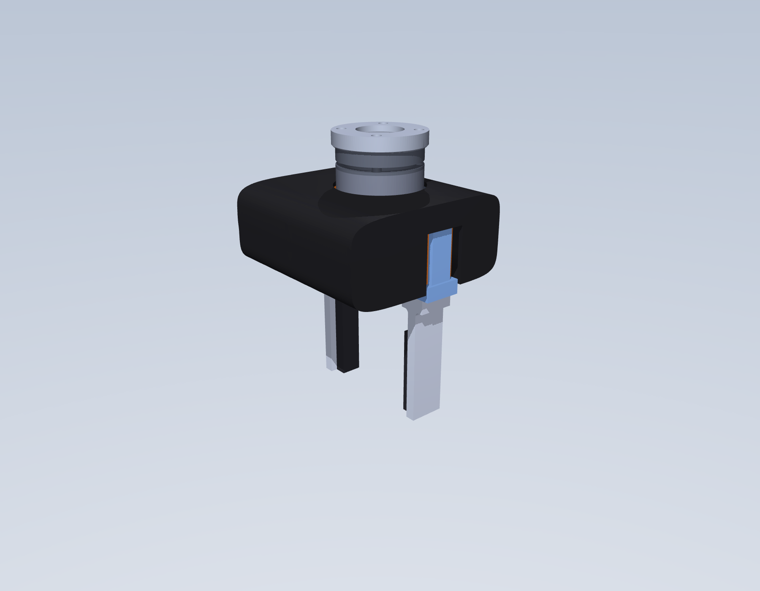
videos/pde-projektplan/assets/work/greifer_iso.png
