eliasbitsch/PDE-Robotergreifer/videos/pde-projektplan/assets/work/greifer_mit_bauteilB.png

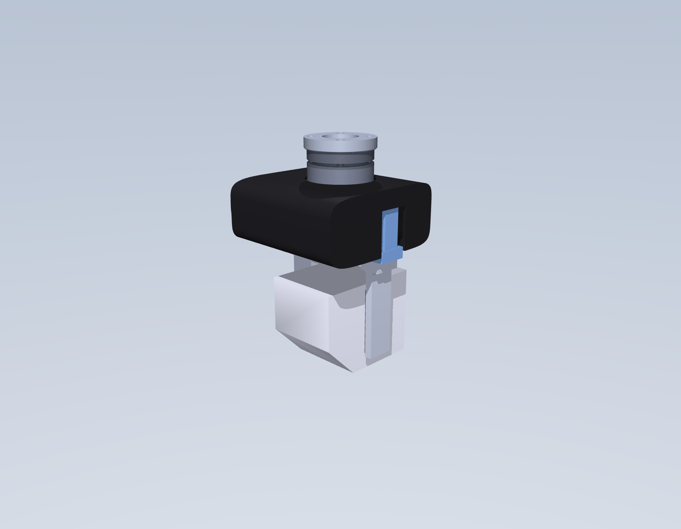
videos/pde-projektplan/assets/work/greifer_mit_bauteilB.png
