eliasbitsch/PDE-Robotergreifer/videos/pde-projektplan/assets/work/konzeptskizze.png

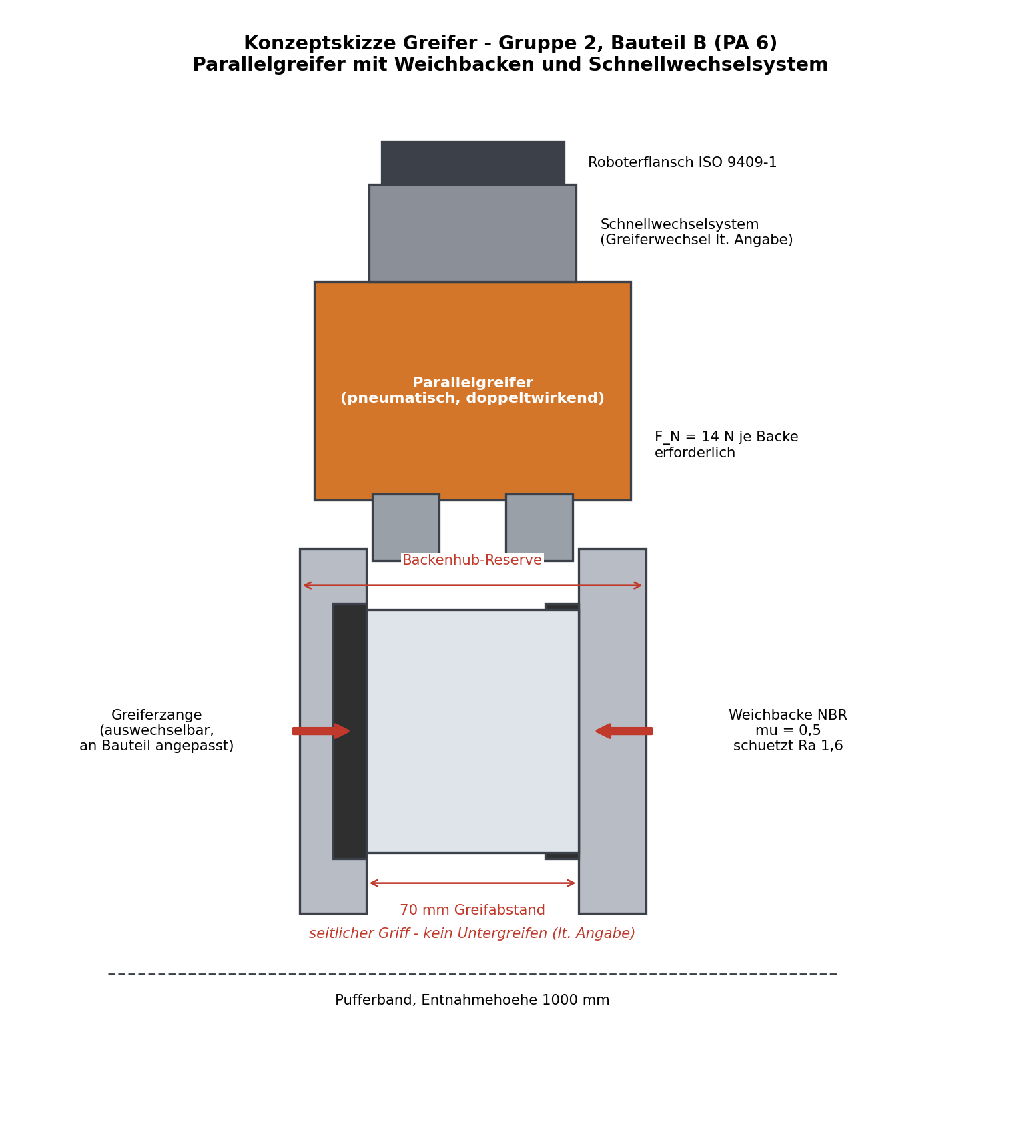
videos/pde-projektplan/assets/work/konzeptskizze.png
