eliasbitsch/PDE-Robotergreifer/videos/pde-projektplan/assets/work/zeichnung.png

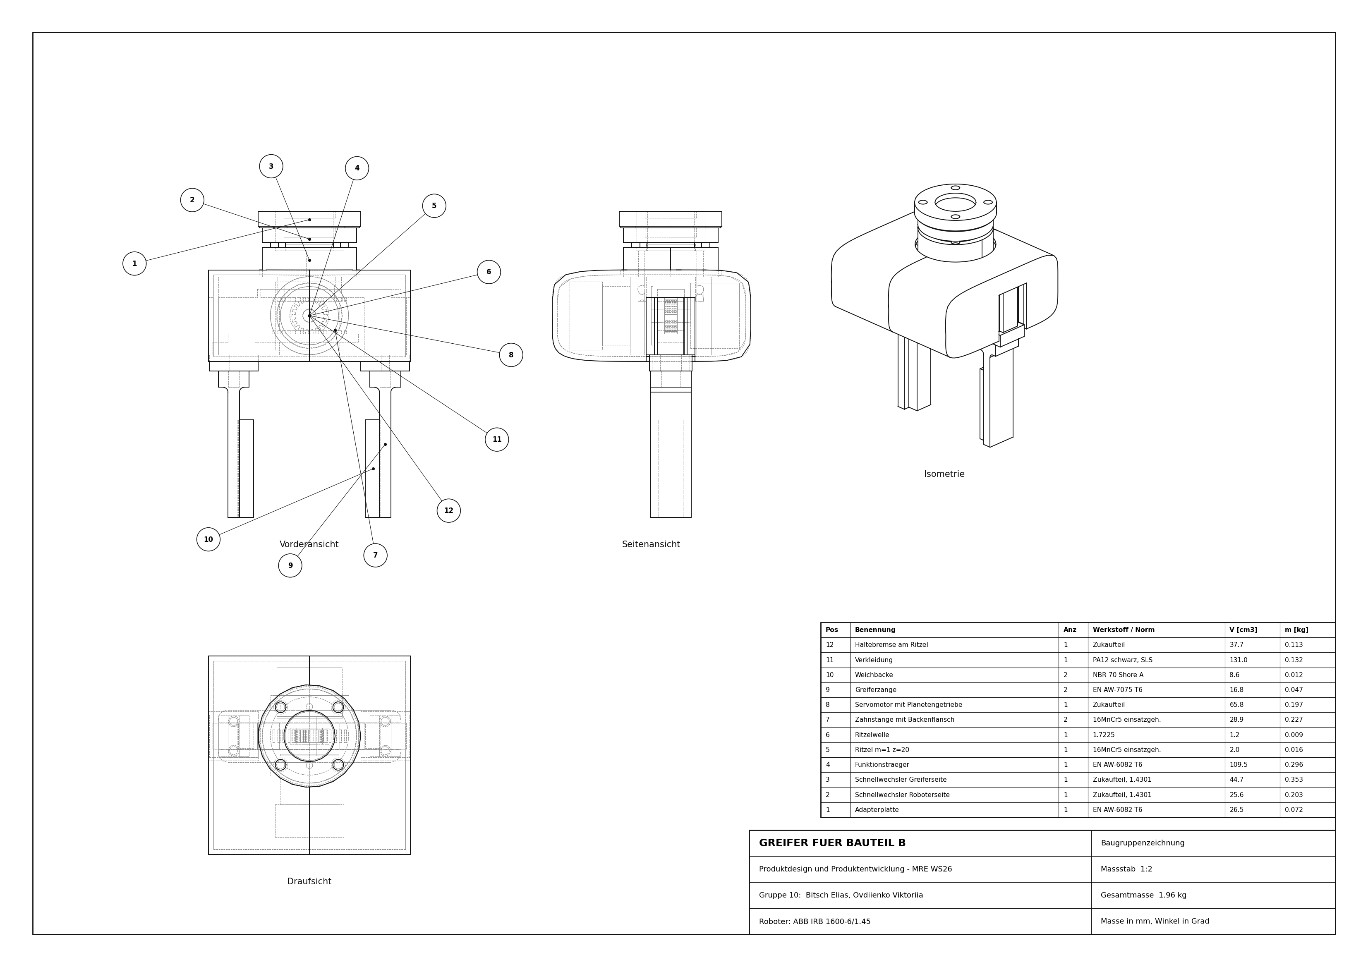
videos/pde-projektplan/assets/work/zeichnung.png
