eliasbitsch/PDE-Robotergreifer/out/step/Greifer_Baugruppe.step

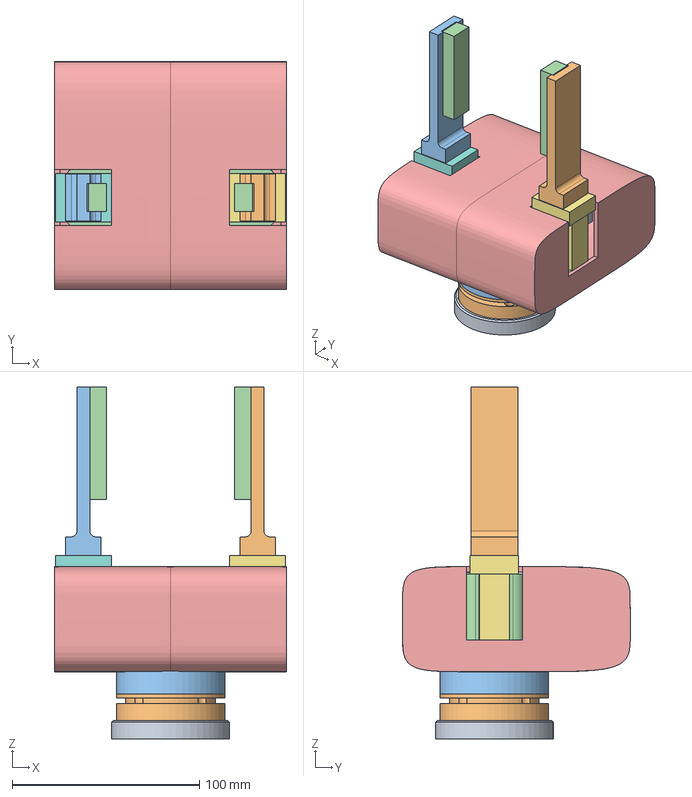
[picture p32: CAD file, 2026-09-12]
out/step/Greifer_Baugruppe.step
124.0 x 121.9 x 188.0 mm
Pos1_Adapterplatte
Pos2_Schnellwechsler_Roboterseite
Pos3_Schnellwechsler_Greiferseite
Pos4_Funktionstraeger
Pos5_Ritzel_m=1_z=20
Pos6_Ritzelwelle
Pos7_Zahnstange_mit_Backenflansch_L
Pos7_Zahnstange_mit_Backenflansch_R
Pos8_Servomotor_mit_Planetengetriebe
Pos9_Greiferzange_L
Pos9_Greiferzange_R
Pos10_Weichbacke_L
Pos10_Weichbacke_R
Pos11_Verkleidung
Pos12_Haltebremse_am_Ritzel
