eliasbitsch/PDE-Robotergreifer/3D-Daten der Bauteile-20260904/Bauteil_C.STEP

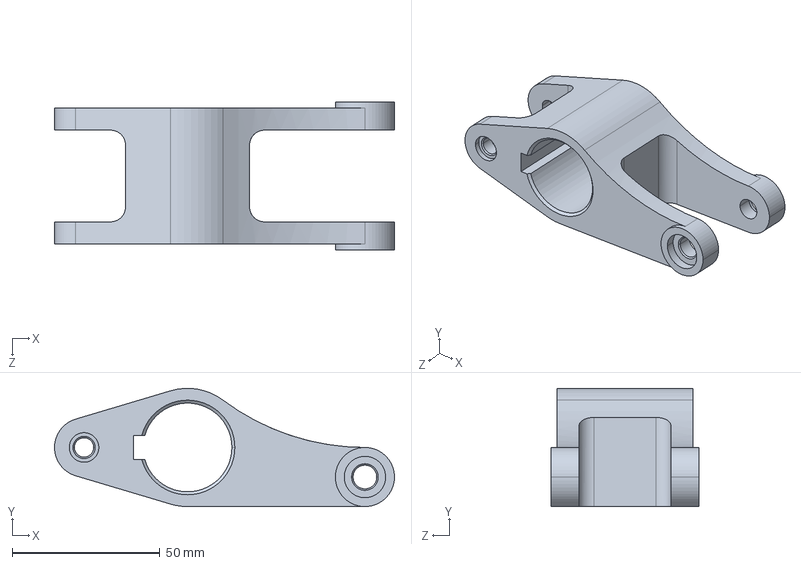
[picture p33: CAD file, 2026-09-12]
3D-Daten der Bauteile-20260904/Bauteil_C.STEP
115.0 x 40.0 x 50.0 mm
