eliasbitsch/PDE-Robotergreifer/out/step/Pos5_Ritzel_m=1_z=20.step

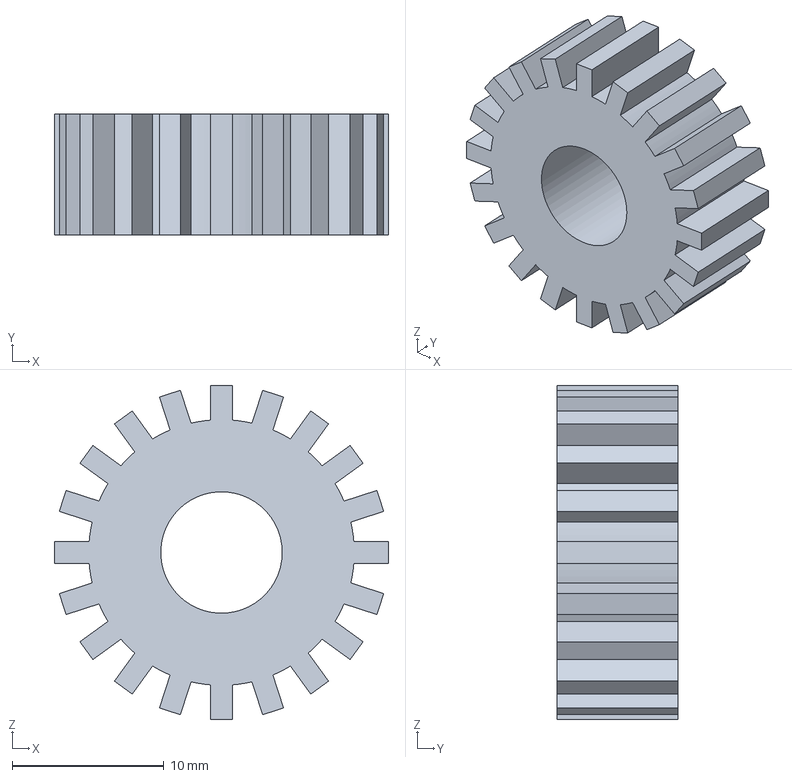
[picture p34: CAD file, 2026-09-12]
out/step/Pos5_Ritzel_m=1_z=20.step
22.0 x 8.00 x 22.0 mm
