eliasbitsch/PDE-Robotergreifer/sim/meshes/bauteil_B.stl

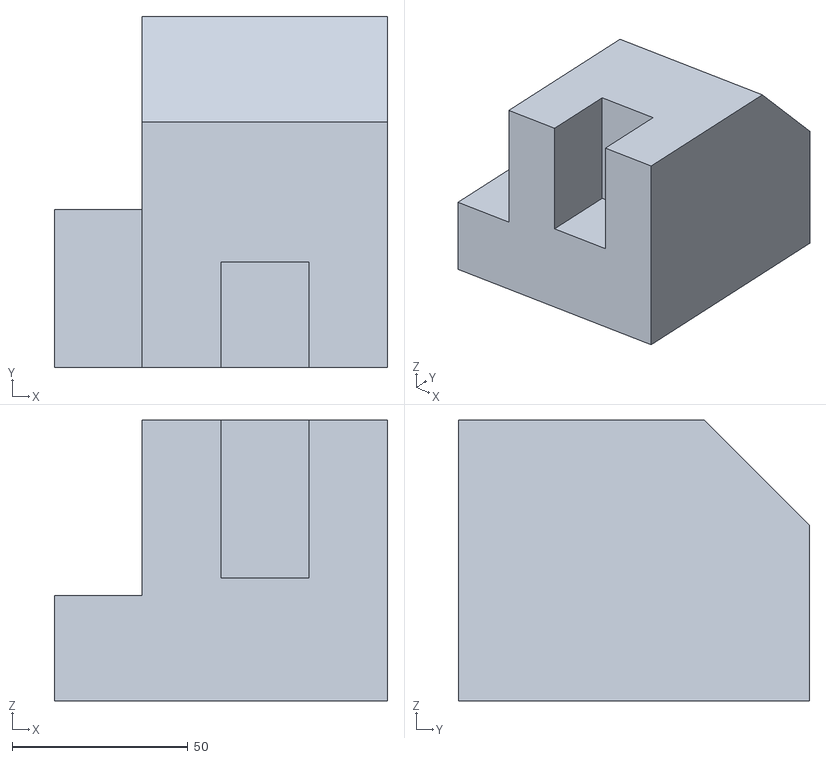
[picture p35: CAD file, 2026-09-12]
sim/meshes/bauteil_B.stl
95.0 x 100.0 x 80.0
