eliasbitsch/PDE-Robotergreifer/sim/meshes/irb1600/collision/link_3.stl

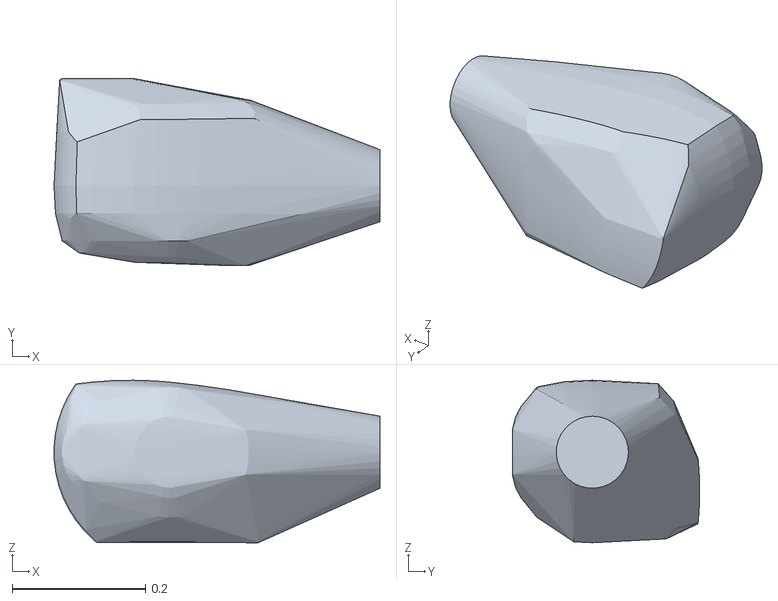
[picture p36: CAD file, 2026-09-12]
sim/meshes/irb1600/collision/link_3.stl
0.489 x 0.281 x 0.244
