eliasbitsch/PDE-Robotergreifer/sim/meshes/irb1600/visual/link_5.stl

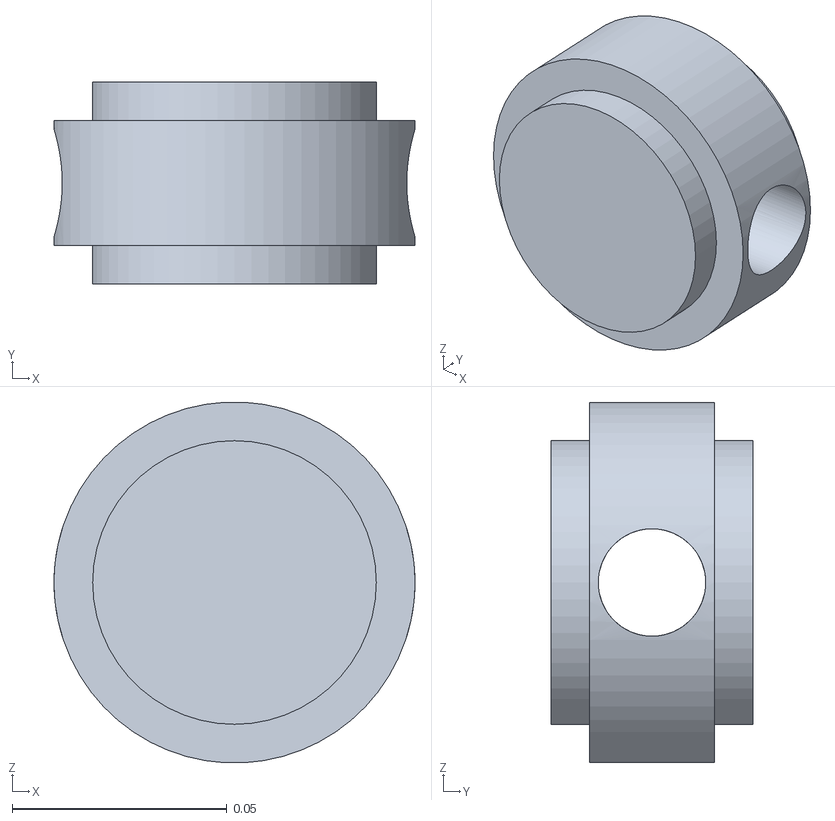
[picture p37: CAD file, 2026-09-12]
sim/meshes/irb1600/visual/link_5.stl
0.084 x 0.047 x 0.0839
