eliasbitsch/PDE-Robotergreifer/3D-Daten der Bauteile-20260904/Bauteil_G.STEP

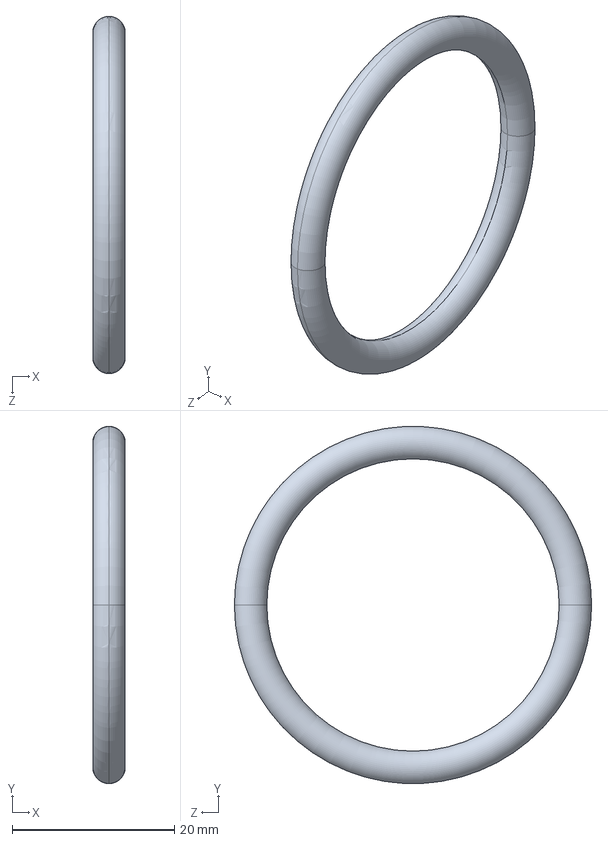
[picture p38: CAD file, 2026-09-12]
3D-Daten der Bauteile-20260904/Bauteil_G.STEP
4.00 x 44.0 x 44.0 mm
