eliasbitsch/PDE-Robotergreifer/out/step/Greiferzange_FEM.step

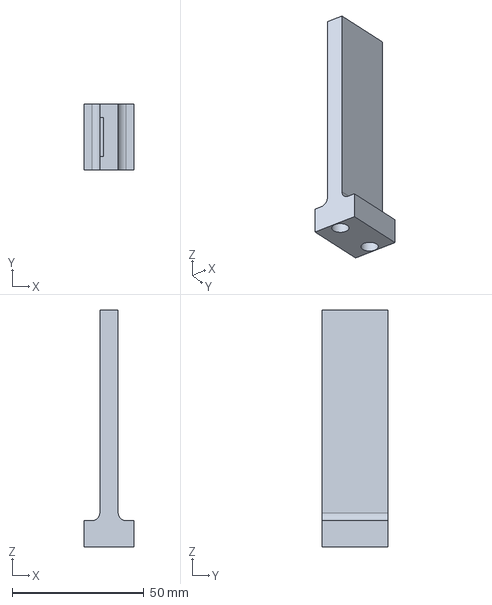
[picture p39: CAD file, 2026-09-12]
out/step/Greiferzange_FEM.step
19.0 x 25.0 x 90.0 mm
