eliasbitsch/PDE-Robotergreifer/sim/meshes/irb1600/collision/link_6.stl

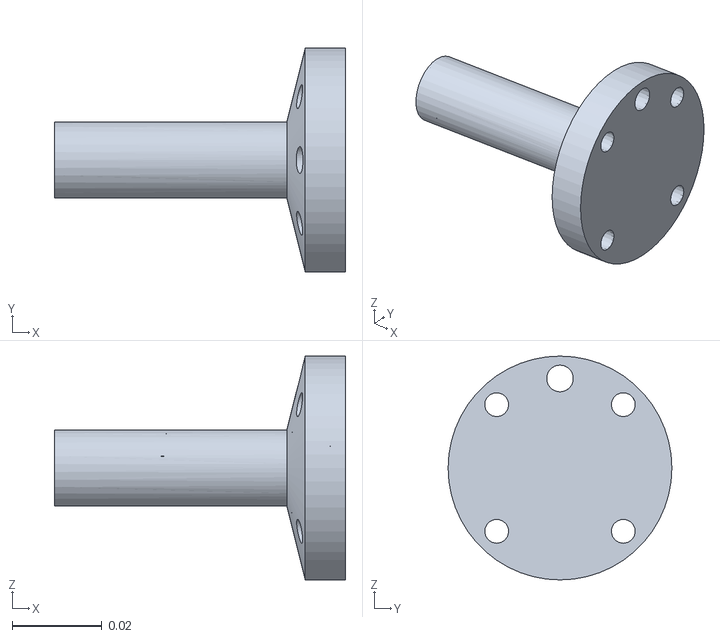
[picture p40: CAD file, 2026-09-12]
sim/meshes/irb1600/collision/link_6.stl
0.065 x 0.05 x 0.05
