eliasbitsch/PDE-Robotergreifer/sim/meshes/irb1600/visual/link_1.stl

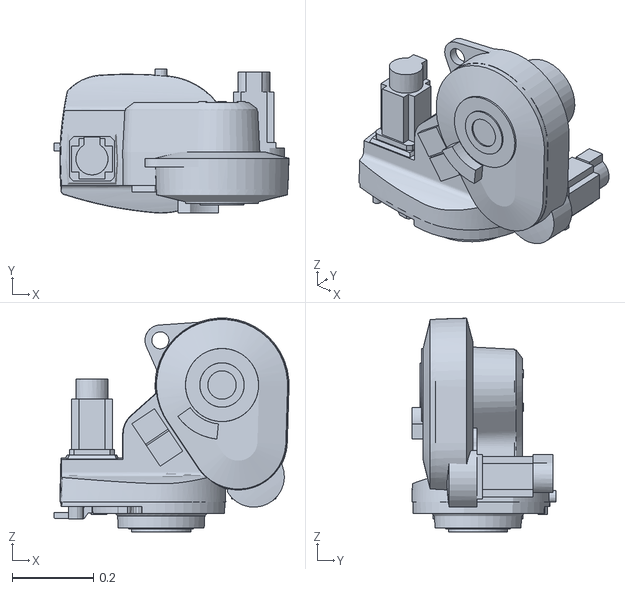
[picture p41: CAD file, 2026-09-12]
sim/meshes/irb1600/visual/link_1.stl
0.579 x 0.356 x 0.527
