eliasbitsch/PDE-Robotergreifer/sim/meshes/irb1600/collision/link_4.stl

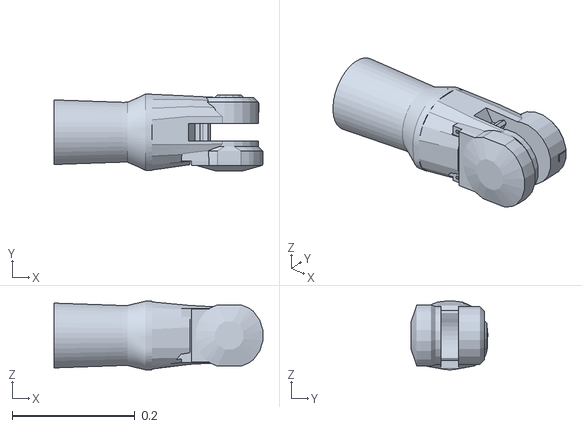
[picture p42: CAD file, 2026-09-12]
sim/meshes/irb1600/collision/link_4.stl
0.341 x 0.125 x 0.112
