eliasbitsch/PDE-Robotergreifer/3D-Daten der Bauteile-20260904/Bauteil_A.STEP

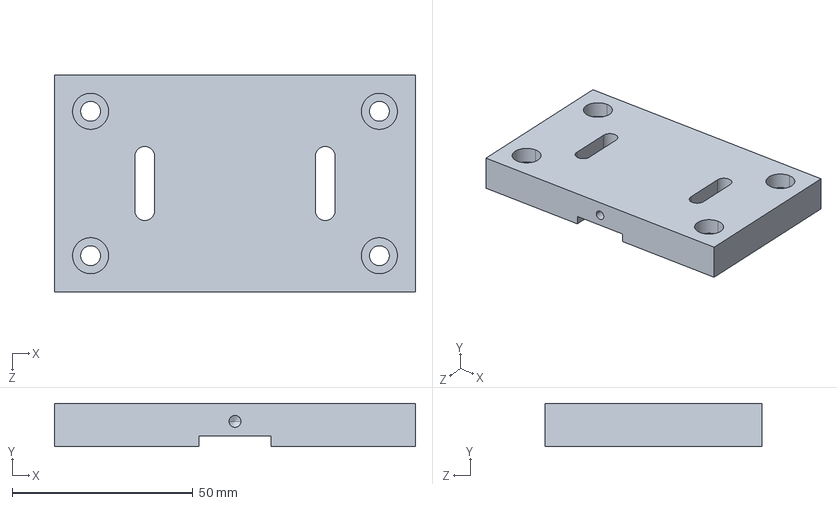
[picture p43: CAD file, 2026-09-12]
3D-Daten der Bauteile-20260904/Bauteil_A.STEP
100.0 x 12.0 x 60.0 mm
