eliasbitsch/PDE-Robotergreifer/3D-Daten der Bauteile-20260904/Bauteil_F.STEP

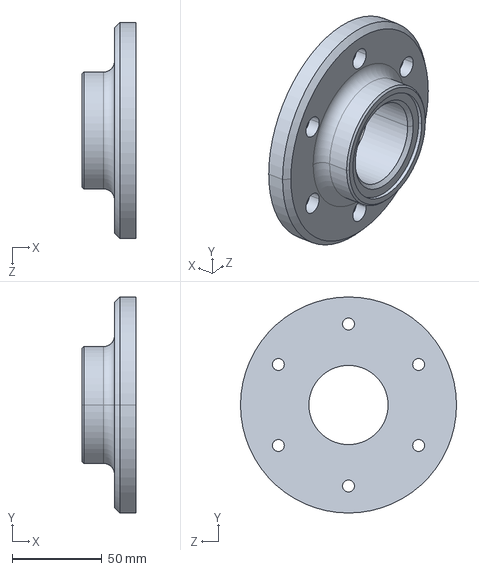
[picture p45: CAD file, 2026-09-12]
3D-Daten der Bauteile-20260904/Bauteil_F.STEP
30.0 x 120.0 x 120.0 mm
