eliasbitsch/PDE-Robotergreifer/out/step/Pos6_Ritzelwelle.step

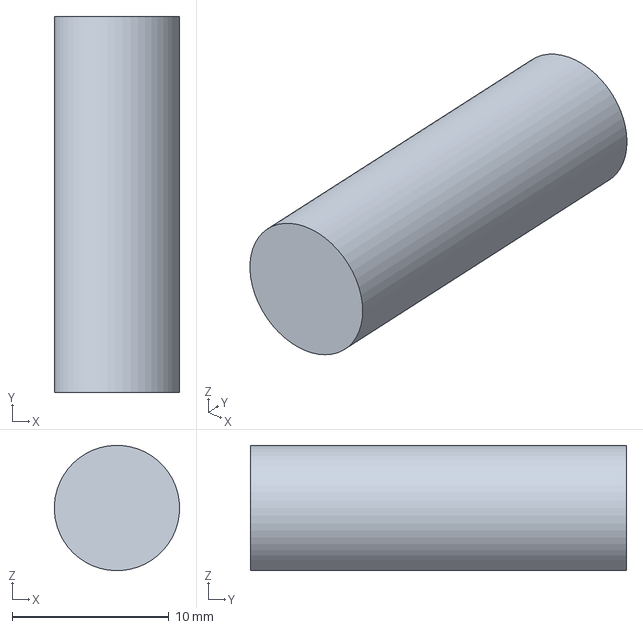
[picture p46: CAD file, 2026-09-12]
out/step/Pos6_Ritzelwelle.step
7.99 x 24.0 x 8.00 mm
