eliasbitsch/PDE-Robotergreifer/3D-Daten der Bauteile-20260904/Bauteil_D.STEP

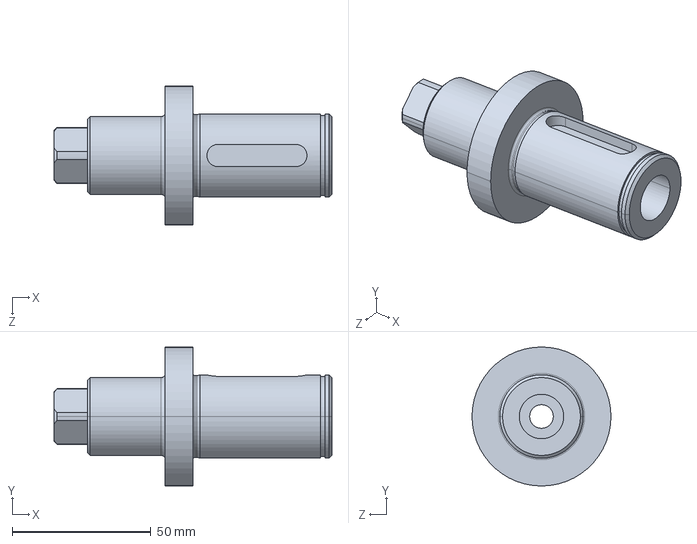
[picture p48: CAD file, 2026-09-12]
3D-Daten der Bauteile-20260904/Bauteil_D.STEP
100.0 x 50.0 x 50.0 mm
