eliasbitsch/PDE-Robotergreifer/out/step/Pos10_Weichbacke_L.step

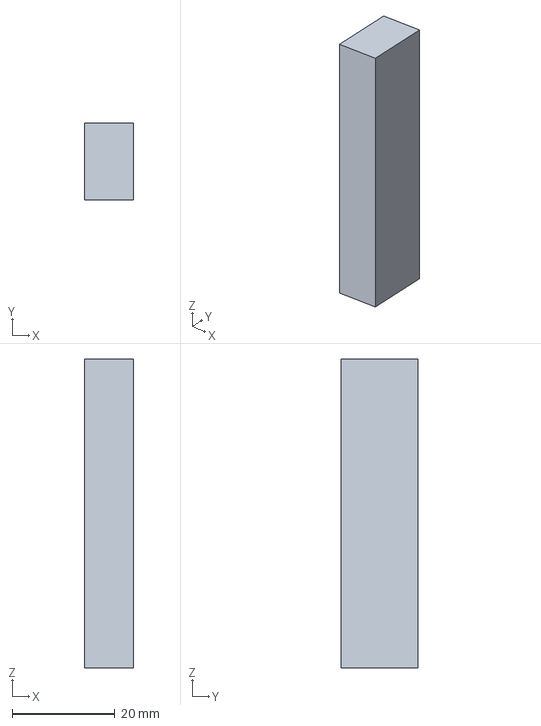
[picture p49: CAD file, 2026-09-12]
out/step/Pos10_Weichbacke_L.step
9.50 x 15.0 x 60.0 mm
