eliasbitsch/PDE-Robotergreifer/sim/meshes/irb1600/collision/base_link.stl

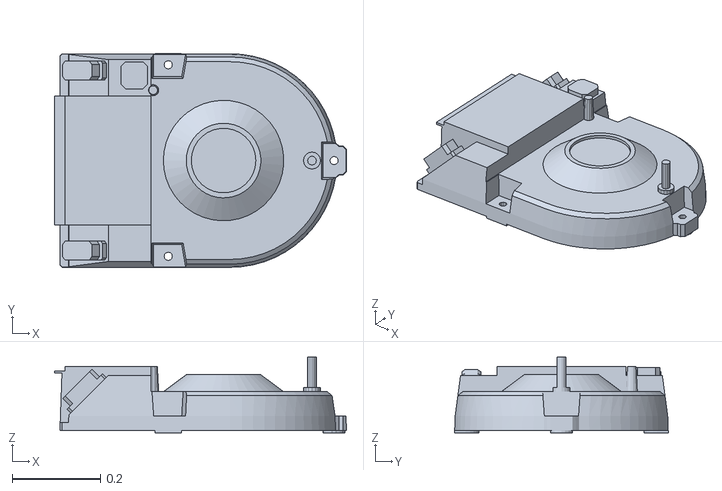
[picture p50: CAD file, 2026-09-12]
sim/meshes/irb1600/collision/base_link.stl
0.66 x 0.483 x 0.171
