eliasbitsch/PDE-Robotergreifer/3D-Daten der Bauteile-20260904/Bauteil_H.STEP

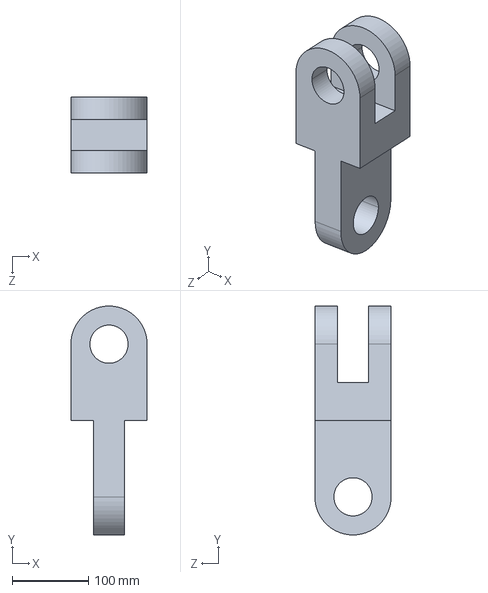
[picture p51: CAD file, 2026-09-12]
3D-Daten der Bauteile-20260904/Bauteil_H.STEP
100.0 x 300.0 x 100.0 mm
