eliasbitsch/PDE-Robotergreifer/out/step/Pos1_Adapterplatte.step

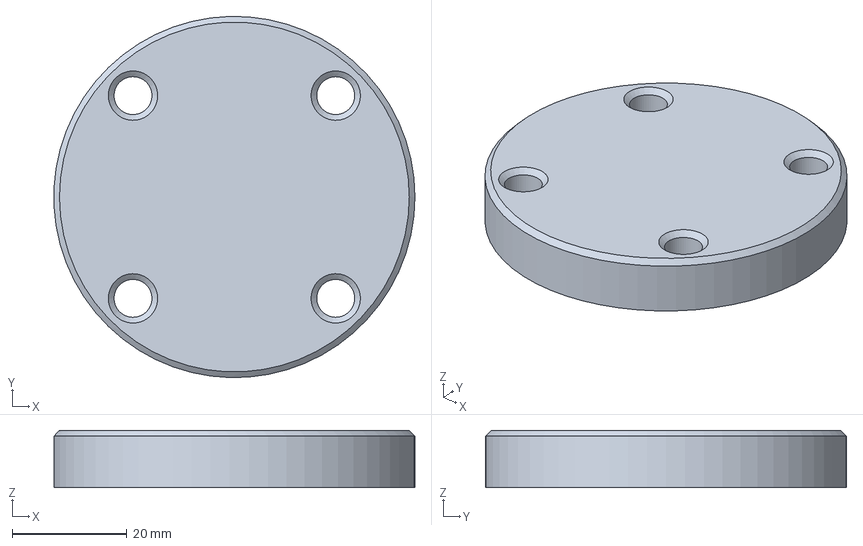
[picture p52: CAD file, 2026-09-12]
out/step/Pos1_Adapterplatte.step
63.0 x 63.0 x 10.0 mm
