eliasbitsch/PDE-Robotergreifer/sim/meshes/irb1600/visual/link_2.stl

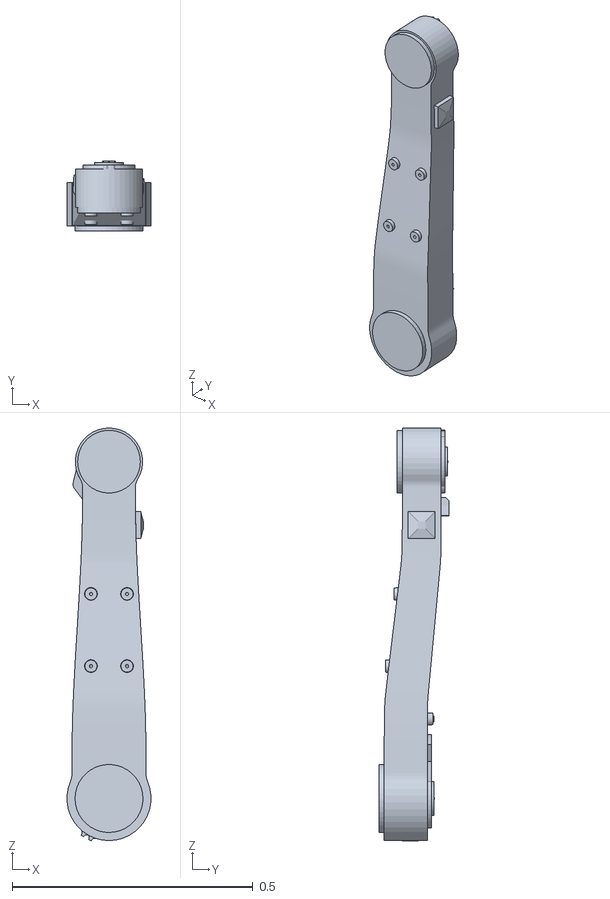
[picture p54: CAD file, 2026-09-12]
sim/meshes/irb1600/visual/link_2.stl
0.174 x 0.146 x 0.858
