eliasbitsch/PDE-Robotergreifer/3D-Daten der Bauteile-20260904/Bauteil_E.STEP

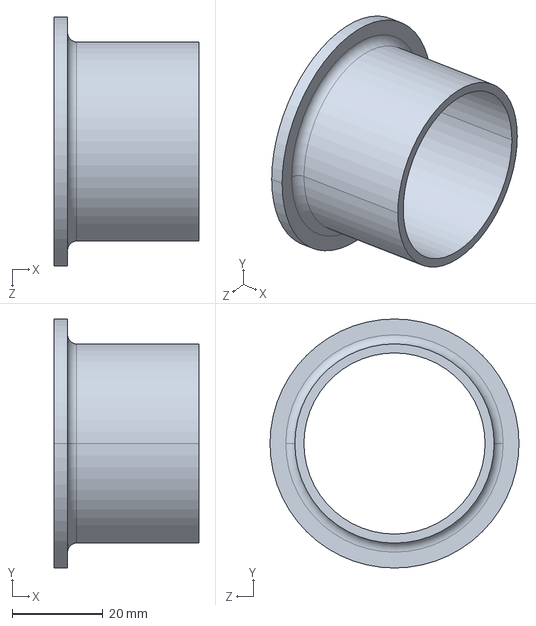
[picture p55: CAD file, 2026-09-12]
3D-Daten der Bauteile-20260904/Bauteil_E.STEP
32.0 x 55.0 x 55.0 mm
