eliasbitsch/PDE-Robotergreifer/out/step/Pos3_Schnellwechsler_Greiferseite.step

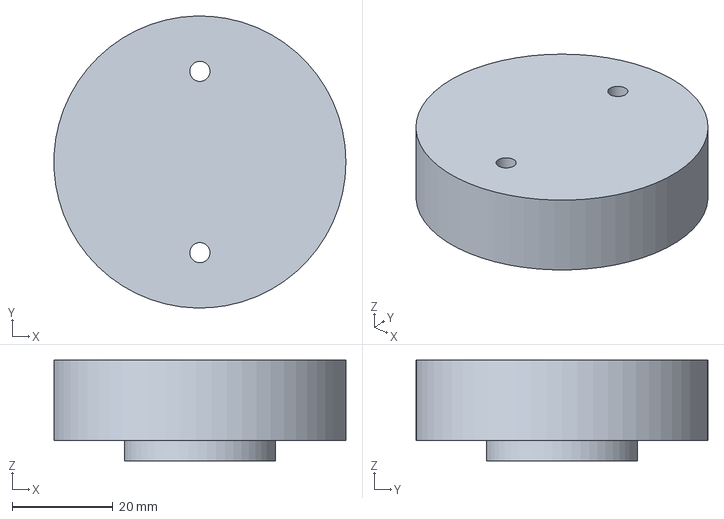
[picture p56: CAD file, 2026-09-12]
out/step/Pos3_Schnellwechsler_Greiferseite.step
58.0 x 58.0 x 20.0 mm
