eliasbitsch/PDE-Robotergreifer/out/step/Pos2_Schnellwechsler_Roboterseite.step

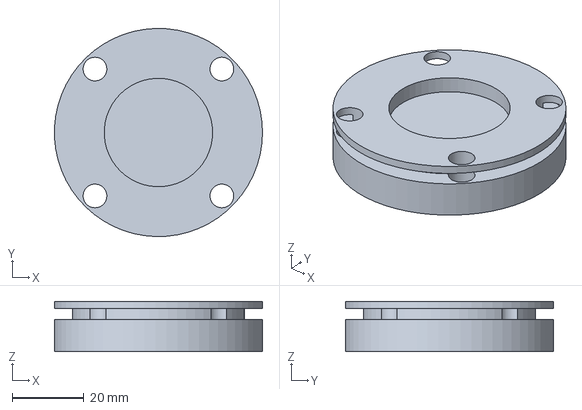
[picture p57: CAD file, 2026-09-12]
out/step/Pos2_Schnellwechsler_Roboterseite.step
58.0 x 58.0 x 14.0 mm
