eliasbitsch/PDE-Robotergreifer/out/step/Pos12_Haltebremse_am_Ritzel.step

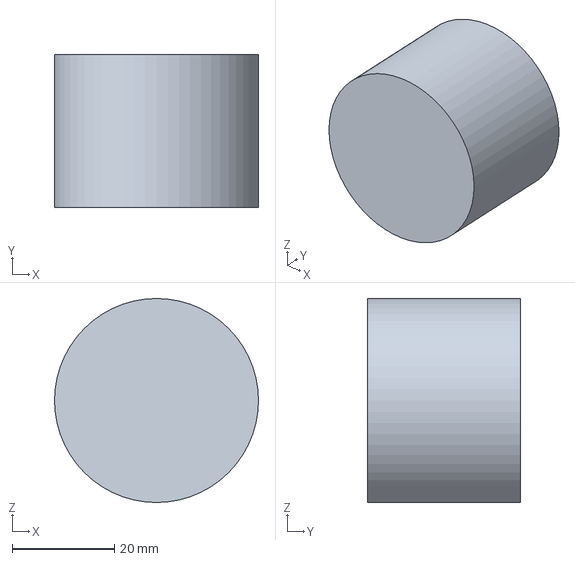
[picture p58: CAD file, 2026-09-12]
out/step/Pos12_Haltebremse_am_Ritzel.step
40.0 x 30.0 x 40.0 mm
