eliasbitsch/PDE-Robotergreifer/out/step/Pos4_Funktionstraeger.step

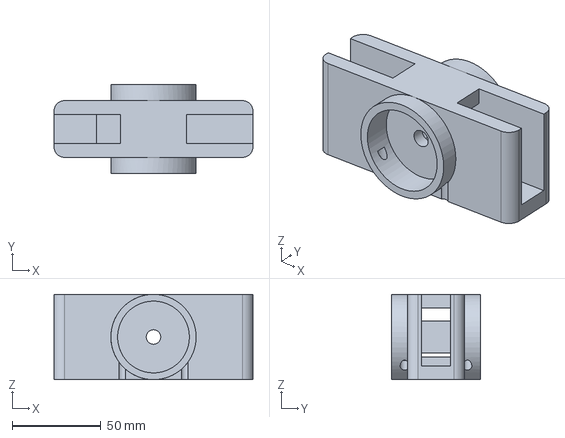
[picture p59: CAD file, 2026-09-12]
out/step/Pos4_Funktionstraeger.step
112.0 x 50.0 x 48.0 mm
