eliasbitsch/PDE-Robotergreifer/out/step/Pos7_Zahnstange_mit_Backenflansch_R.step

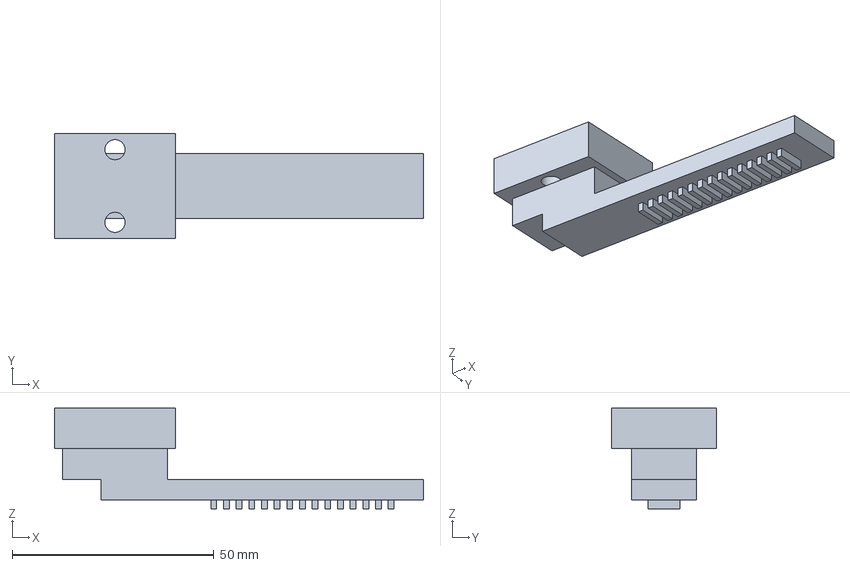
[picture p60: CAD file, 2026-09-12]
out/step/Pos7_Zahnstange_mit_Backenflansch_R.step
91.5 x 26.0 x 25.0 mm
