eliasbitsch/PDE-Robotergreifer/out/step/Pos8_Servomotor_mit_Planetengetriebe.step

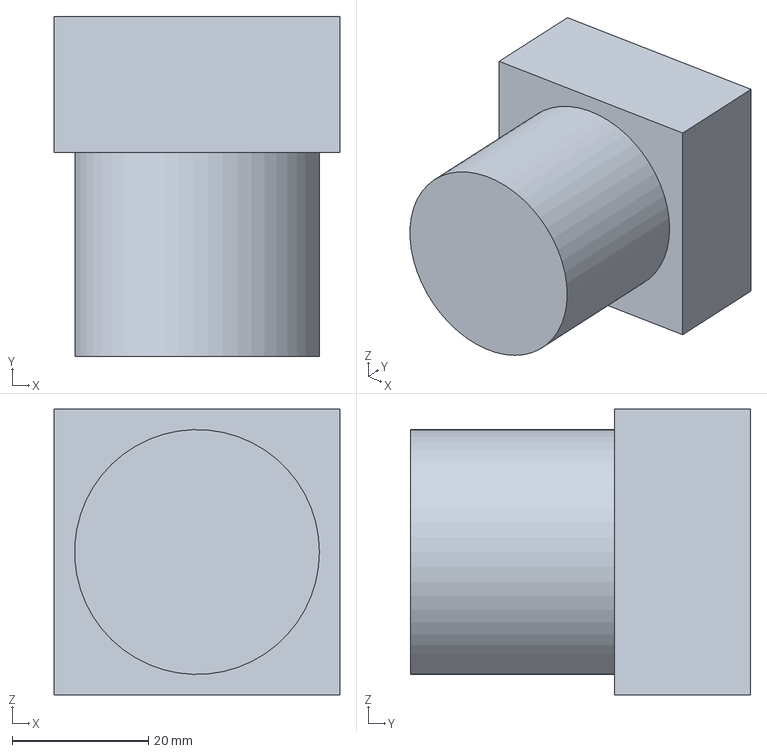
[picture p61: CAD file, 2026-09-12]
out/step/Pos8_Servomotor_mit_Planetengetriebe.step
42.0 x 50.0 x 42.0 mm
