eliasbitsch/PDE-Robotergreifer/out/step/Pos7_Zahnstange_mit_Backenflansch_L.step

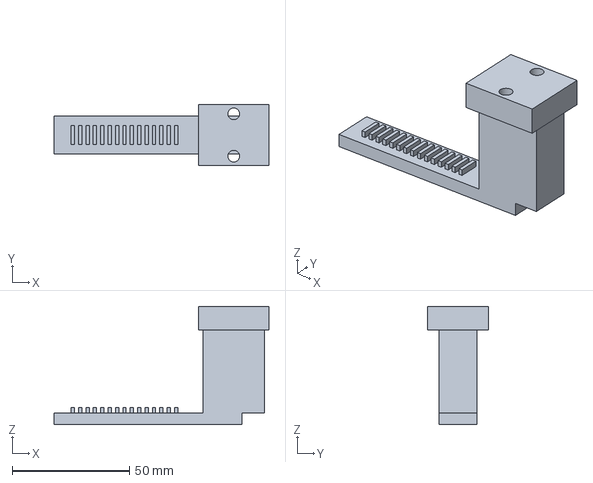
[picture p62: CAD file, 2026-09-12]
out/step/Pos7_Zahnstange_mit_Backenflansch_L.step
91.5 x 26.0 x 50.2 mm
