eliasbitsch/PDE-Robotergreifer/out/step/Pos11_Verkleidung.step

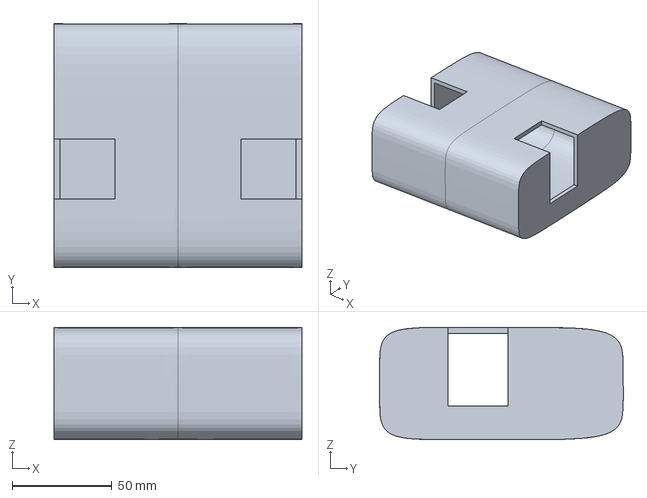
[picture p63: CAD file, 2026-09-12]
out/step/Pos11_Verkleidung.step
124.0 x 121.9 x 56.2 mm
