eliasbitsch/PDE-Robotergreifer/out/step/Pos8_Servomotor_mit_GetriebeBremse.step

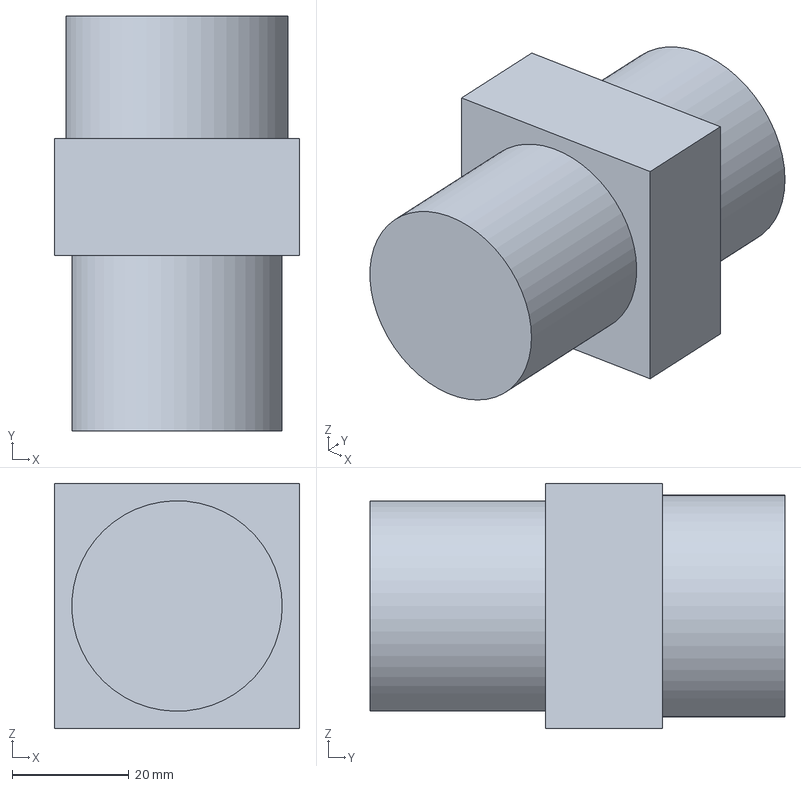
[picture p64: CAD file, 2026-09-12]
out/step/Pos8_Servomotor_mit_GetriebeBremse.step
42.0 x 71.0 x 42.0 mm
