eliasbitsch/PDE-Robotergreifer/out/step/Pos4_Greifergehaeuse.step

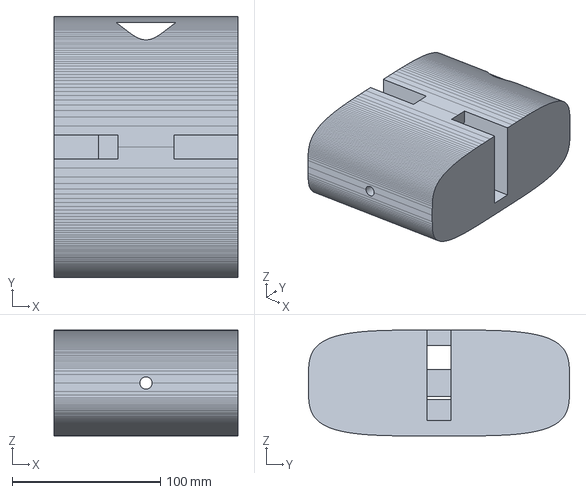
[picture p65: CAD file, 2026-09-12]
out/step/Pos4_Greifergehaeuse.step
124.0 x 176.0 x 71.4 mm
