eliasbitsch/PDE-Robotergreifer/out/step/Pos6_Greiferzange.step

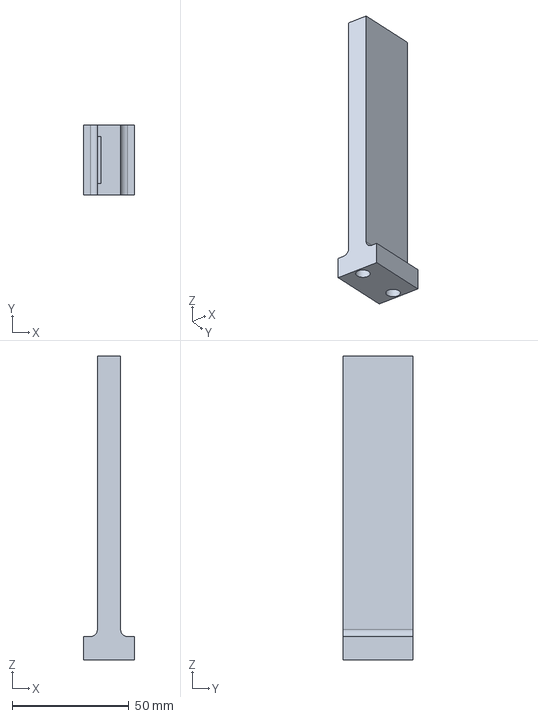
[picture p66: CAD file, 2026-09-12]
out/step/Pos6_Greiferzange.step
22.0 x 30.0 x 130.0 mm
