eliasbitsch/PDE-Robotergreifer/out/step/Pos7_Zahnstange_mit_Schlitten_R.step

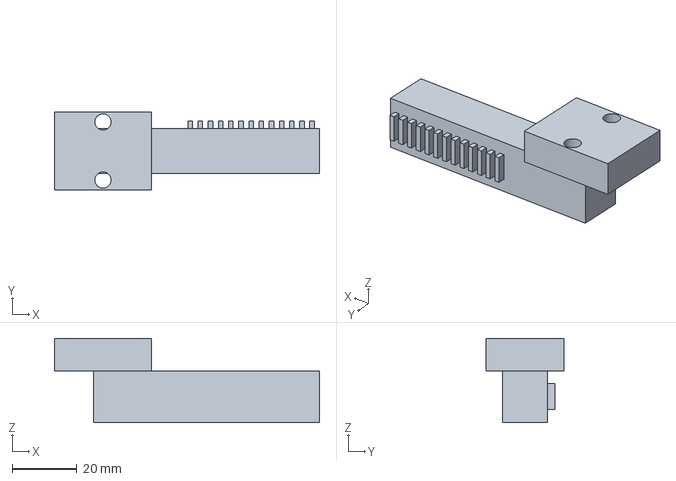
[picture p67: CAD file, 2026-09-12]
out/step/Pos7_Zahnstange_mit_Schlitten_R.step
82.0 x 24.0 x 26.0 mm
