eliasbitsch/PDE-Robotergreifer/out/step/Pos10_Greiferzange_R.step

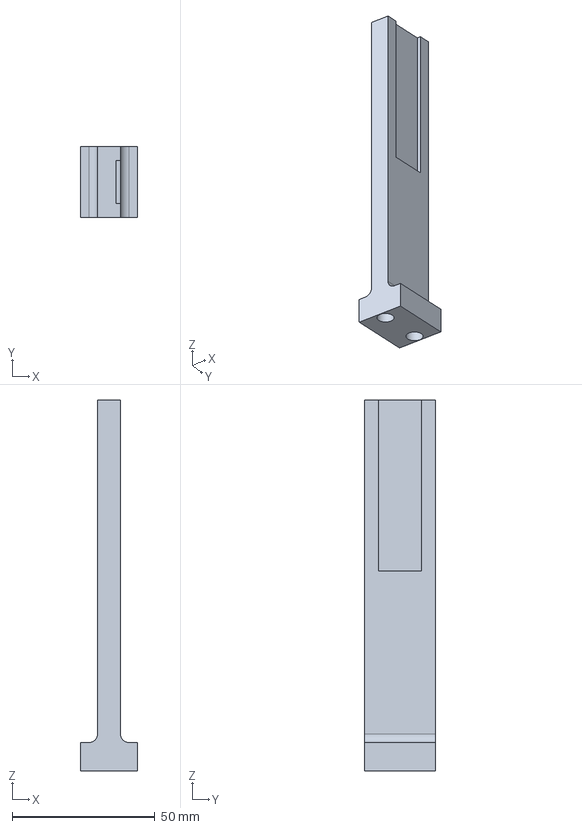
[picture p68: CAD file, 2026-09-12]
out/step/Pos10_Greiferzange_R.step
20.0 x 25.0 x 130.0 mm
