eliasbitsch/PDE-Robotergreifer/out/step/Pos7_Zahnstange_mit_Schlitten_L.step

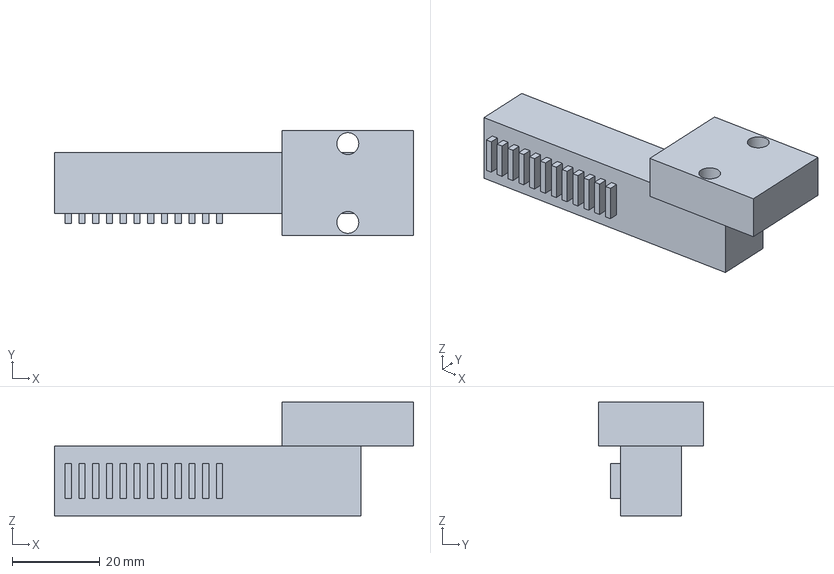
[picture p69: CAD file, 2026-09-12]
out/step/Pos7_Zahnstange_mit_Schlitten_L.step
82.0 x 24.0 x 26.0 mm
