eliasbitsch/PDE-Robotergreifer/out/step/Pos5_Zylinderdeckel.step

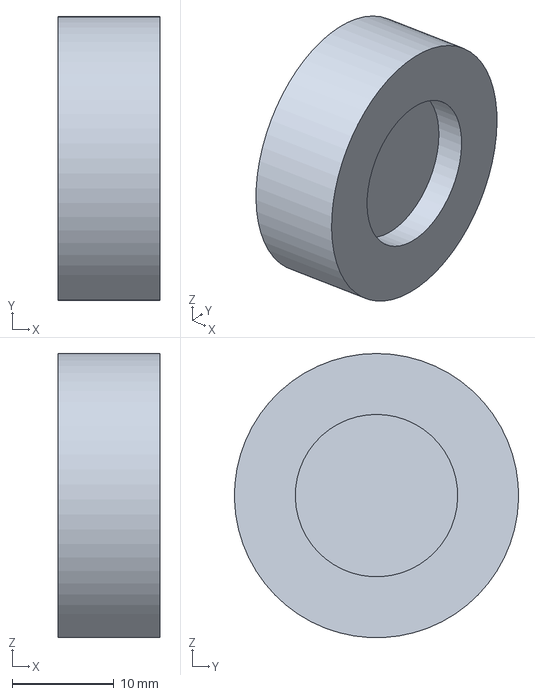
[picture p70: CAD file, 2026-09-12]
out/step/Pos5_Zylinderdeckel.step
10.0 x 28.0 x 28.0 mm
