eliasbitsch/PDE-Robotergreifer/out/step/Pos4_Greifergrundkoerper.step

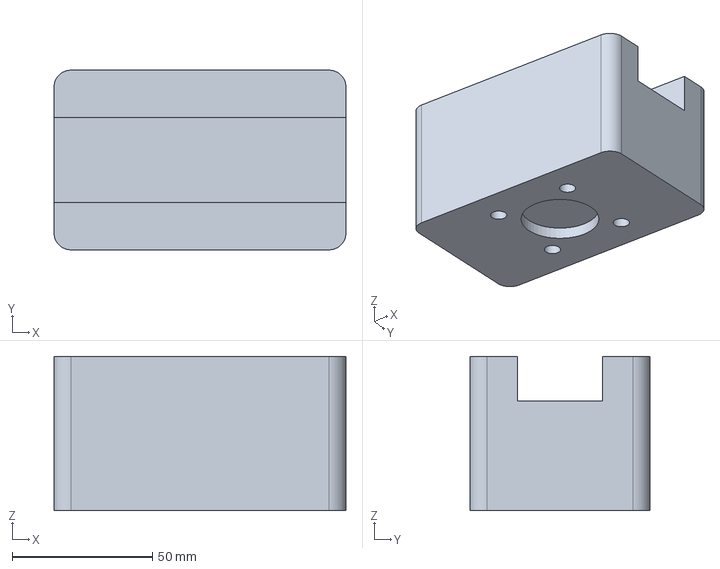
[picture p71: CAD file, 2026-09-12]
out/step/Pos4_Greifergrundkoerper.step
104.0 x 64.0 x 55.0 mm
