eliasbitsch/PDE-Robotergreifer/out/step/Pos9_Ritzelwelle.step

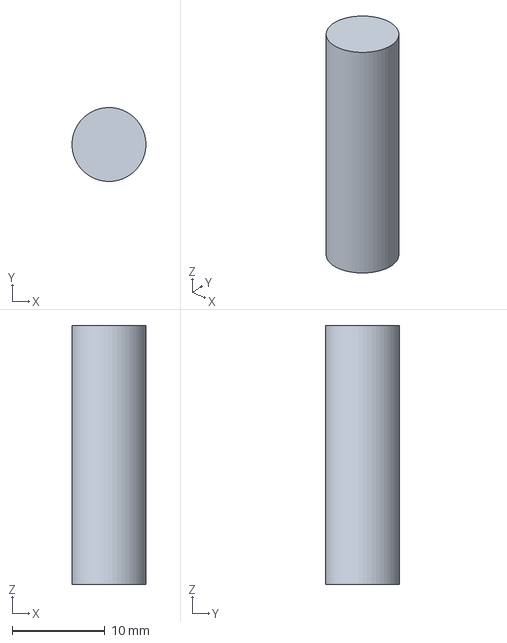
[picture p72: CAD file, 2026-09-12]
out/step/Pos9_Ritzelwelle.step
7.99 x 8.00 x 28.0 mm
