eliasbitsch/PDE-Robotergreifer/out/step/Pos8_Ritzel_m=1_z=16.step

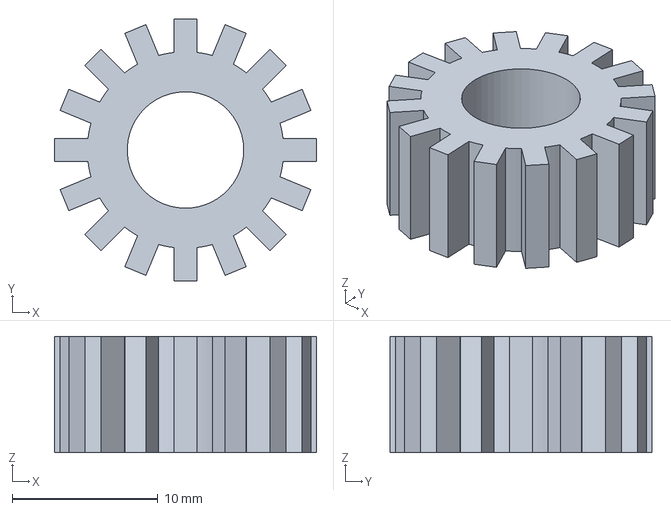
[picture p73: CAD file, 2026-09-12]
out/step/Pos8_Ritzel_m=1_z=16.step
18.0 x 18.0 x 8.00 mm
