eliasbitsch/PDE-Robotergreifer/out/step/Pos7_Weichbacke.step

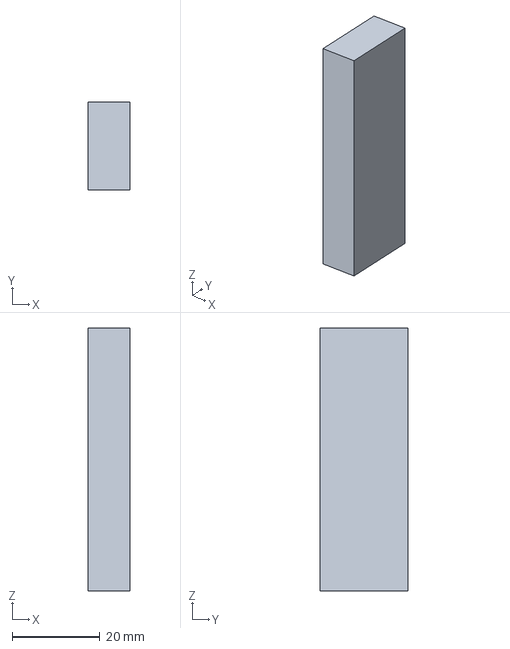
[picture p74: CAD file, 2026-09-12]
out/step/Pos7_Weichbacke.step
9.50 x 20.0 x 60.0 mm
