eliasbitsch/PDE-Robotergreifer/out/step/Pos5_Schlitten_Grundbacke.step

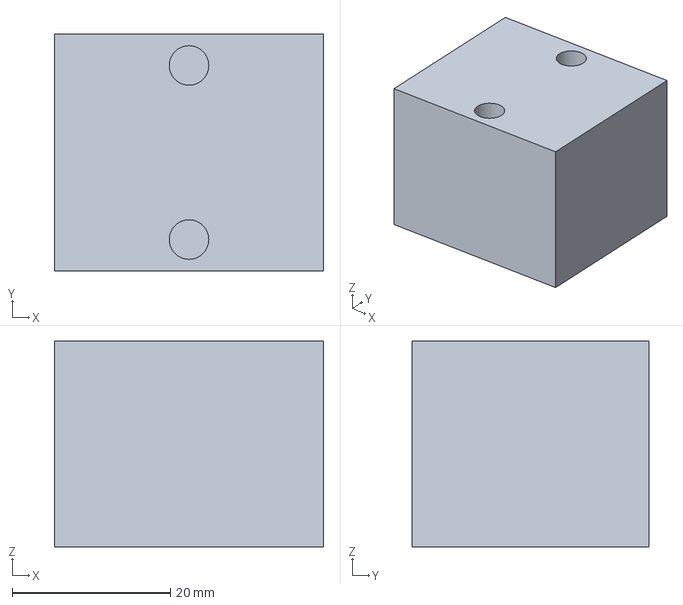
[picture p75: CAD file, 2026-09-12]
out/step/Pos5_Schlitten_Grundbacke.step
34.0 x 30.0 x 26.0 mm
