eliasbitsch/PDE-Robotergreifer/out/step/Pos6_Kolben_mit_Kolbenstange.step

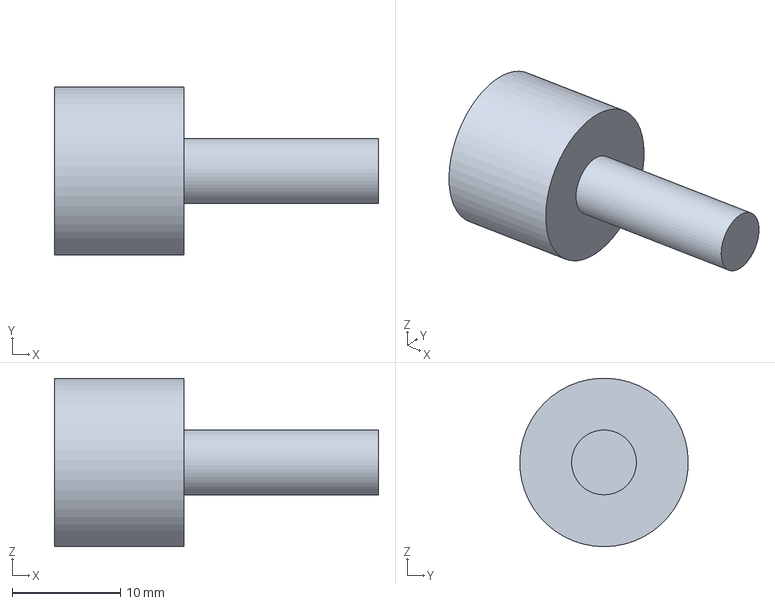
[picture p76: CAD file, 2026-09-12]
out/step/Pos6_Kolben_mit_Kolbenstange.step
30.0 x 15.6 x 15.6 mm
