eliasbitsch/PDE-Robotergreifer/(list of files, cad)

Other CAD files:
3D-Daten der Bauteile-20260904/Bauteil_B.STEP
out/step/Pos9_Greiferzange_L.step
out/step/Pos10_Weichbacke_R.step
out/step/Pos9_Greiferzange_R.step
out/step/Pos11_Weichbacke_R.step
out/step/Pos10_Greiferzange_L.step
out/step/Pos11_Weichbacke_L.step
