eliasbitsch/PDE-Robotergreifer/(commit log)

2026-09-12 PDE Greifer: Servoantrieb, FEM-Kette, nativer Onshape-Aufbau
    Stand nach der Umstellung von Pneumatik auf Servo (Zahnstange-Ritzel,
    NEMA 17 mit Planetengetriebe i=5 und Haltebremse).
    - cad/: parametrische Konstruktion, Variantenvergleich, Rendering
    - fem/: analytischer und numerischer Festigkeitsnachweis (gmsh + CalculiX)
    - sim/: Arbeitsablauf und Kollisionskontrolle (MuJoCo, ABB IRB 1600)
    - docs/: Baugruppenzeichnung mit Stueckliste
    - onshape/: nativer FeatureScript-Aufbau, API-Zugriff ueber Session
    [Bauteil_A.STEP, Bauteil_B.STEP, Bauteil_C.STEP, Bauteil_D.STEP, Bauteil_E.STEP, Bauteil_F.STEP, Bauteil_G.STEP, Bauteil_H.STEP]
2026-09-12 Design: Antrieb integriert, alle Hauptmasse hergeleitet
    - NEMA 17 Pancake statt Standard-Bauform (20 statt 34 mm), belegt ueber
    Momentbedarf 0,069 Nm und Mindestreserve 2,0
    - Gehaeuse mit zylindrischem Ausleger statt angeschraubtem Motor
    - cad/nachweise.py: Maskette mit Herleitung je Groesse
    Dabei zwei Fehler gefunden:
    - Backenhub war 12 mm, geometrisch noetig sind 12,5 + Freigang = 14 mm
    (Bauteil 95 mm breit, Greifabstand 70 mm)
    - Auslegerdurchmesser war 54 mm, noetig sind 67,4 mm (Umkreis des
    quadratischen NEMA-Flansches 59,4 mm plus Wand)
    [Greifer_Baugruppe.step, Greiferzange_FEM.step, Pos10_Weichbacke_L.step, Pos10_Weichbacke_R.step, Pos1_Adapterplatte.step, Pos2_Schnellwechsler_Roboterseite.step, Pos3_Schnellwechsler_Greiferseite.step, Pos4_Greifergehaeuse.step]
2026-09-12 Design: Squircle-Verkleidung, werkstoffgerechte Trennung
    Aussenform als Superellipse (n=4) statt Quader mit Anbauten. Der Antrieb
    liegt vollstaendig innen, es steht nichts mehr heraus.
    Werkstofftrennung nach Funktion:
    - Pos.4 Funktionstraeger, Alu gefraest: nur lastfuehrende Teile (0,45 kg)
    - Pos.11 Verkleidung, PA12 schwarz SLS: lastfreie Aussenhaut, 3 mm (0,21 kg)
    Ein massiver Alu-Squircle waere 2,56 kg - getrennt sind es 0,66 kg.
    Alle Hauptmasse hergeleitet (cad/nachweise.py):
    - Squircle-Halbachsen aus Antriebslaenge und Mechanikhoehe
    - Gehaeusehoehe aus der Schaleninnenkontur
    - NEMA 17 Pancake belegt ueber Momentbedarf und Mindestreserve 2,0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
    [Greifer_Baugruppe.step, Greiferzange_FEM.step, Pos10_Weichbacke_L.step, Pos10_Weichbacke_R.step, Pos11_Verkleidung.step, Pos1_Adapterplatte.step, Pos2_Schnellwechsler_Roboterseite.step, Pos3_Schnellwechsler_Greiferseite.step]
2026-09-12 Kompakter: Bauhoehe 242 -> 188 mm, Hoehenkette durchgaengig hergeleitet
    - Zangenlaenge aus der Bauteilgeometrie statt gesetzt: 120 -> 80 mm
    (Luft + Randmass + Backenlaenge; Greifflaeche laeuft ueber die volle
    Bauteilhoehe, belegt in analyze_B.py)
    - Zahnstangenhoehe aus Festigkeit und Zahnanbindung: 14 -> 5 mm
    - Gehaeusehoehe folgt daraus; massgebend ist jetzt der NEMA-17-Flansch
    - SQ_C: Flansch steht achsparallel, die Diagonale war falsch angesetzt
    (kostete 17 mm Bauhoehe)
    - Verkleidungsdurchbrueche aus der Mechanik abgeleitet statt fest
    Nebeneffekt: Zangendurchbiegung 0,16 -> 0,03 mm, damit unter dem
    Weichbelag (0,059 mm) - das offene Steifigkeitskriterium ist erfuellt.
    Masse 2,34 ->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
    [Greifer_Baugruppe.step, Greiferzange_FEM.step, Pos10_Weichbacke_L.step, Pos10_Weichbacke_R.step, Pos11_Verkleidung.step, Pos1_Adapterplatte.step, Pos2_Schnellwechsler_Roboterseite.step, Pos3_Schnellwechsler_Greiferseite.step]
2026-09-12 Bautiefe 176 -> 122 mm: Bremse aufs freie Wellenende, Profil asymmetrisch
    - Haltebremse sitzt nicht mehr hinter dem Motor, sondern auf dem freien
    Ritzelwellenende in -Y. Sie nutzt damit den Raum, der ohnehin leer war.
    Preis: sie haelt jetzt das volle Ritzelmoment (0,31 statt 0,07 Nm) und
    wird groesser. Vorteil: kein Getriebespiel zwischen Bremse und Last.
    Eigene Stuecklistenposition 12.
    - Superellipse asymmetrisch: a+ = 72,7 (Antrieb), a- = 49,1 (Bremse).
    Beide Haelften treffen sich bei y = 0 tangentenstetig.
    - Halbachsen nicht mehr als Summe, sondern aus der Einschlussbedingung
    (y/a)^n + (z/c)^n <= 1 ueber alle Einbauteile, iterativ geloest. Die
    Superellipse verjuengt sich zu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
    [Greifer_Baugruppe.step, Greiferzange_FEM.step, Pos10_Weichbacke_L.step, Pos10_Weichbacke_R.step, Pos11_Verkleidung.step, Pos12_Haltebremse_am_Ritzel.step, Pos1_Adapterplatte.step, Pos2_Schnellwechsler_Roboterseite.step]
2026-09-12 Zangendicke aus der Steifigkeit hergeleitet, FEM-Kette nachgezogen
    - ZANGE_H war mit 8 mm gesetzt. Der Festigkeitsnachweis liefert Sicherheit
    > 40, taugt also nicht zur Auslegung. Massgebend ist, dass sich die Zange
    nicht staerker verformt als der Weichbelag, auf dem sie aufliegt - sonst
    bestimmt ihre Federung die Greifkraft mit. Daraus h_noetig = 6,70 -> 7 mm.
    - Analytisch + CalculiX auf der neuen Geometrie (L 80, h 7, F 33,1 N):
    sig_v 13,14 analytisch / 11,84 FEM (-9,9 %)
    u_max 0,052 / 0,066 mm (+27,3 %, Anschraubkopf federt mit)
    Netzkonvergenz ueber 5 Stufen bis lc = 0,7 mm, Fehlerschaetzer 2,0 %
    - Ablaufsimulation neu gerechnet: 99 Bahnpunkte kollision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
    [Greifer_Baugruppe.step, Greiferzange_FEM.step, Pos10_Weichbacke_L.step, Pos10_Weichbacke_R.step, Pos11_Verkleidung.step, Pos12_Haltebremse_am_Ritzel.step, Pos1_Adapterplatte.step, Pos2_Schnellwechsler_Roboterseite.step]
2026-09-12 Zeichnung lesbar: Spline statt Polygonzug, Greifer haengt richtig herum
    Zwei Fehler in der Baugruppenzeichnung:
    - Vorder- und Draufsicht liefen schwarz zu. Ursache war die Verkleidung:
    das Squircle-Profil war ein 240-Eck, daraus entstanden 240 Regelflaechen
    (518 Flaechen, 1560 Kanten), von denen jede eine eigene Kante projizierte.
    Jetzt ein periodischer Spline durch 96 Stuetzstellen -> 17 Flaechen,
    55 Kanten. Flaechenfehler gegenueber 240 Stuetzstellen < 0,05 %.
    Nebeneffekt: die STEP-Datei beschreibt die Kurve, statt sie zu facettieren.
    - Der Greifer stand auf dem Kopf. Im Modell liegt der Flansch bei z = 0 und
    +Z zeigt zum Bauteil; in der Zeichnung gehoert der Flansch nach oben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
    [Greifer_Baugruppe.step, Greiferzange_FEM.step, Pos10_Weichbacke_L.step, Pos10_Weichbacke_R.step, Pos11_Verkleidung.step, Pos12_Haltebremse_am_Ritzel.step, Pos1_Adapterplatte.step, Pos2_Schnellwechsler_Roboterseite.step]
2026-09-14 Projektplan und Arbeitsteilung: Ordner je Person, Abgabestruktur nach Abb.2
    Vorarbeit war Experiment, jetzt startet das eigentliche Projekt. PLAN.md legt
    Technik (Servo, 2-Finger-Parallelgreifer, Onshape, MuJoCo), Aufgabenteilung
    Elias/Viktoriia und Timeline fest. Abgabetermin ist noch angenommen.
    Jede/r committet nur im eigenen Ordner, zusammengefuehrt wird am Ende in
    gemeinsam/abgabe/.
2026-09-14 Echte LV-Termine eingearbeitet: Zwischenbericht 26.11., Endkontrolle 15.01.
    Wir sind in getrennten LV-Gruppen (BB-1/BB-2), fahren aber beide nach BB-1.
    Das sind die frueheren Termine und kostet je eine Woche Puffer - muss deshalb
    mit der LV-Leitung abgesprochen werden, steht jetzt als Punkt 0 auf der
    Klaerliste.
    Meilensteine an die Vorlesungstermine gehaengt: CAD startet nach der
    Onshape-Einfuehrung, FEM liegt vor dem Zwischenbericht statt danach.
2026-09-14 Punkteverteilung und die fuenf LV-Warnungen in den Plan gezogen
    Aus der Einfuehrungsfolie: 100 Punkte, davon 20 auf die 3D-Konstruktion und
    10 allein auf die Ausfuehrung der Dokumentation. Danach umpriorisiert.
    Die fuenf Warnungen ("damit euer Projekt nicht scheitert") sind jetzt explizit
    den Meilensteinen zugeordnet. Zwei Konsequenzen: die Baugruppenzeichnung
    wandert von Januar nach Dezember, und die Doku laeuft ab M1 mit statt am Ende.
    Beim Zwischenbericht muss nur eine Person pro Gruppe anwesend sein - das
    entschaerft die BB-1/BB-2-Frage.
    moodle/ ist ignoriert, Kursmaterial gehoert nicht ins Repo.
2026-09-14 Pitch-Video fuer Viktoriia: Plan, Termine, Aufgabenteilung, Setup
    HyperFrames-Komposition, 1:17 min, stumm. Sieben Szenen: Titel, die zwei harten
    Termine, Punkteverteilung, Aufgabenteilung, Gantt-Timeline, das
    Claude-MCP-Onshape-Setup und der Schluss mit Repo-Link.
    Echte Logos und echte Website-Screenshots statt nachgebauter Kacheln. Der
    Onshape-Screenshot bewirbt FeatureScript MCP auf ihrer eigenen Startseite -
    das belegt die Toolchain besser als jede Behauptung. Dazu eigene Arbeitsbilder
    aus der Vorarbeit (FEM-Konvergenz, Ablaufsimulation, Zeichnung, Skizze), damit
    sichtbar ist, dass die Kette laeuft.
    Capture-Ordner und .media sind ignoriert, nur die verwendeten Assets liegen im
    Repo.
    C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
2026-09-14 FEM und FDM wandern zu Elias, Viktoriia rechnet analytisch
    Aufteilung war schief - Viktoriia hatte Konzept, Auslegung, Zangen-CAD,
    analytische Rechnung UND FEM. Jetzt rechnet sie analytisch, Elias numerisch:
    zwei unabhaengige Wege auf dasselbe Bauteil, wie die Angabe es verlangt, und
    eine Abweichung faellt auf statt sich in einer Hand zu verstecken.
    LaTeX als Werkzeug fuer Berechnung und Doku ergaenzt, Onshape deckt CAD und
    FEM ab.
2026-09-14 Video neu: englisch, weniger Text, Bauteil und Greifpunkte sichtbar
    Neun Szenen statt sieben. Neu sind das Bauteil selbst (aus Bauteil_B.STEP
    ueber build123d getesselt), die Greifpunkte als Draufsicht mit beiden
    Greifflaechen, Backenpfeilen und 70-mm-Bemassung, die Begruendung fuer
    2-Finger-Parallelgreifer und Servoantrieb, und die Werkzeugkette
    Onshape / LaTeX / MuJoCo / GitHub.
    Die Draufsicht ersetzt die Iso-Ansicht bei den Greifpunkten: bei zwei
    gegenueberliegenden Flaechen ist in jeder Iso-Ansicht eine davon verdeckt,
    der Pfeil zeigte auf eine graue Flaeche.
    FEM ist in der Aufteilung zu Elias gewandert.
    Renders sind ignoriert - die MP4s gehoeren nicht in die History.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
2026-09-14 Punkteverteilung wieder im Video, FDM-Druck zurueck zu Viktoriia
    Eigene Szene vor der Aufteilung: erst was was wert ist, dann wer was nimmt.
    Die 3D-Konstruktion mit 20 Punkten steht als einziger voller Balken da, der
    Rest je 10.
    Der gedruckte Nachweis wandert von Elias zu Viktoriia. Elias rechnet die FEM,
    also darf er sie nicht selbst mit dem Druckteil bestaetigen - Viktoriia misst
    die Durchbiegung und haelt sie gegen sein Ergebnis.
2026-09-15 Punktezahl neben jedem Paket in der Aufteilungsszene
    Jedes Paket zeigt jetzt seinen Wert, die 3D-Konstruktion als "20 P - both",
    weil sie geteilt wird. Dazu eine Summenzeile je Spalte (30 bzw. 40 Punkte
    aus eigenen Paketen plus die geteilte CAD) und die Doku-Zeile, weil die
    10 Dokumentationspunkte sonst in keiner Spalte auftauchen.
2026-09-15 Konzeptwechsel: Viergelenk statt Zahnstange-Ritzel, Robotiq als Vorbild
    Der alte Variantenvergleich hatte mit Zahnstange, Keilhaken und Trapezspindel
    nur direkt uebersetzende Schubmechanismen im Feld - Gelenkgetriebe fehlten
    ganz. Mit dem Viergelenk kippt das Ergebnis, vor allem bei "Halten bei
    Energieausfall": die selbsthemmende Spindel erspart die Haltebremse, die die
    Zahnstange zwingend gebraucht haette.
    Uebernommen wird die Topologie des Robotiq 2F-85, nicht seine Unteraktuierung.
    Der umgreifende Modus ist statisch unbestimmt und bringt fuer zwei ebene
    Flaechen nichts.
    Startgeometrie gerechnet: Lenker 90 mm, Schwenkwinkel +-4,46 Grad, Hub 14 mm
    je Seite, Belagversatz 0,27 mm ueber den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
